SkillSurf/cmos-pll-ihp-sg13g2/Team Designs/Team 2 Design/design_data/xschem/plots/vctl_vs_freq.xlsx

vctl | fnew | f old
0.4 | 0.0228 | 0.00296
0.5 | 0.132 | 0.021
0.6 | 0.39 | 0.025
0.7 | 0.708 | 0.076
0.8 | 1.077 | 0.207
0.9 | 1.316 | 0.465
1 | 1.42 | 0.86
1.1 | 1.5 | 1.44
1.2 | 1.46 | 2.1
