SkillSurf/cmos-pll-ihp-sg13g2/Combined_Design/design_data/gds/images/11Stage_vco_new_gds.png

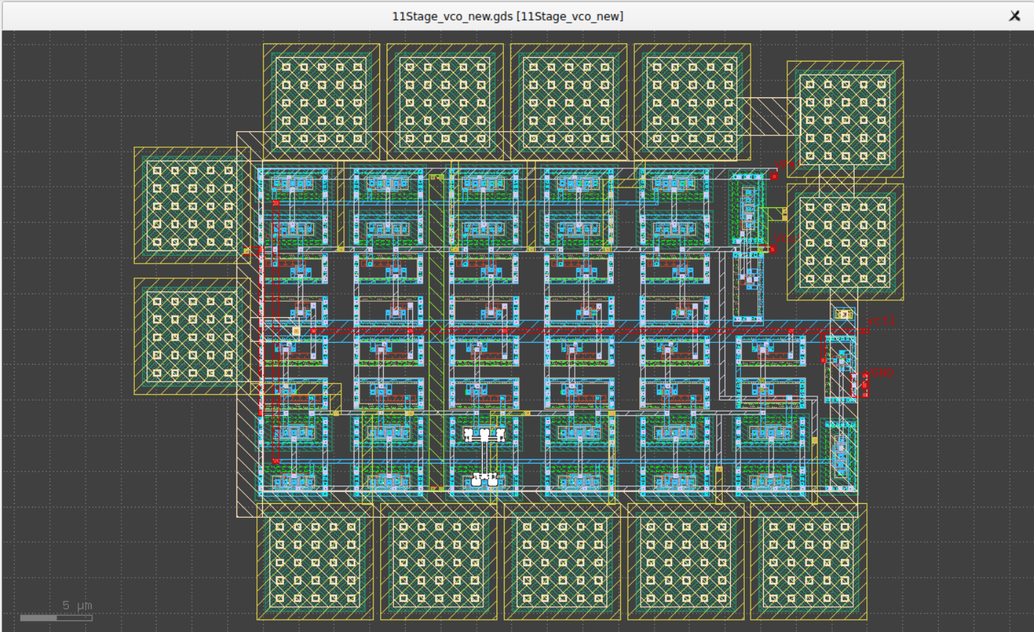
Combined_Design/design_data/gds/images/11Stage_vco_new_gds.png
