SkillSurf/cmos-pll-ihp-sg13g2/Combined_Design/design_data/gds/images/bias_gen_layout.png

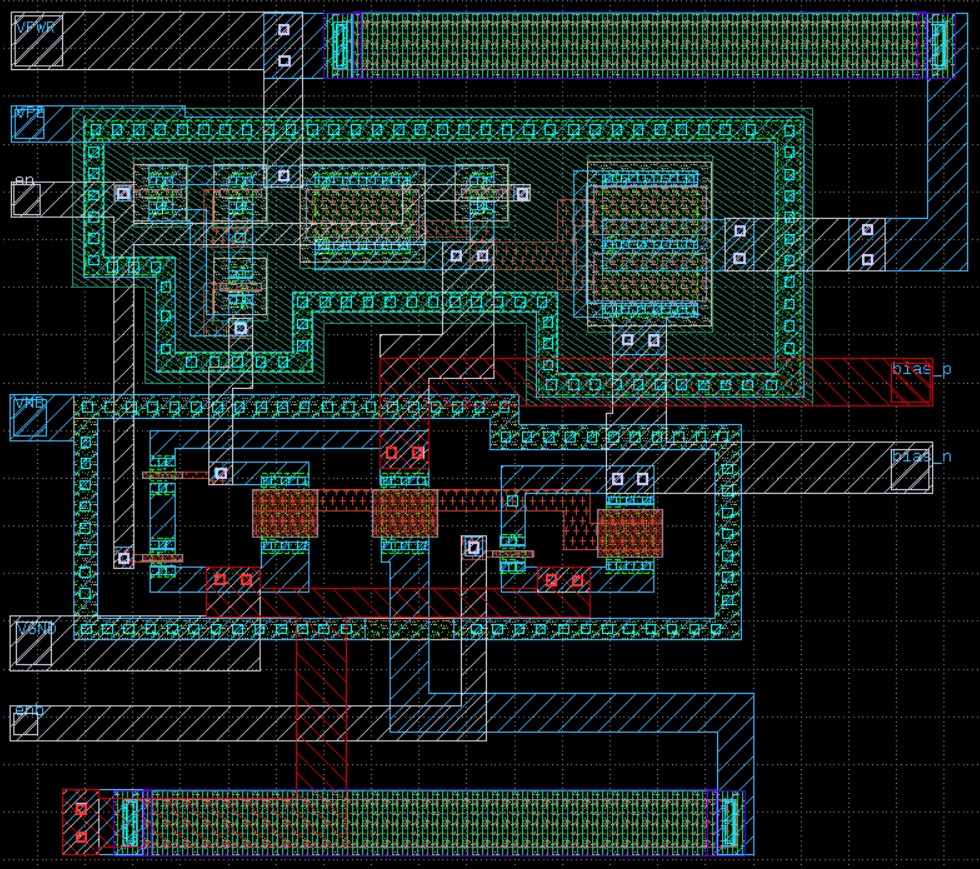
Combined_Design/design_data/gds/images/bias_gen_layout.png
