SkillSurf/cmos-pll-ihp-sg13g2/Combined_Design/design_data/gds/images/charge_pump.png

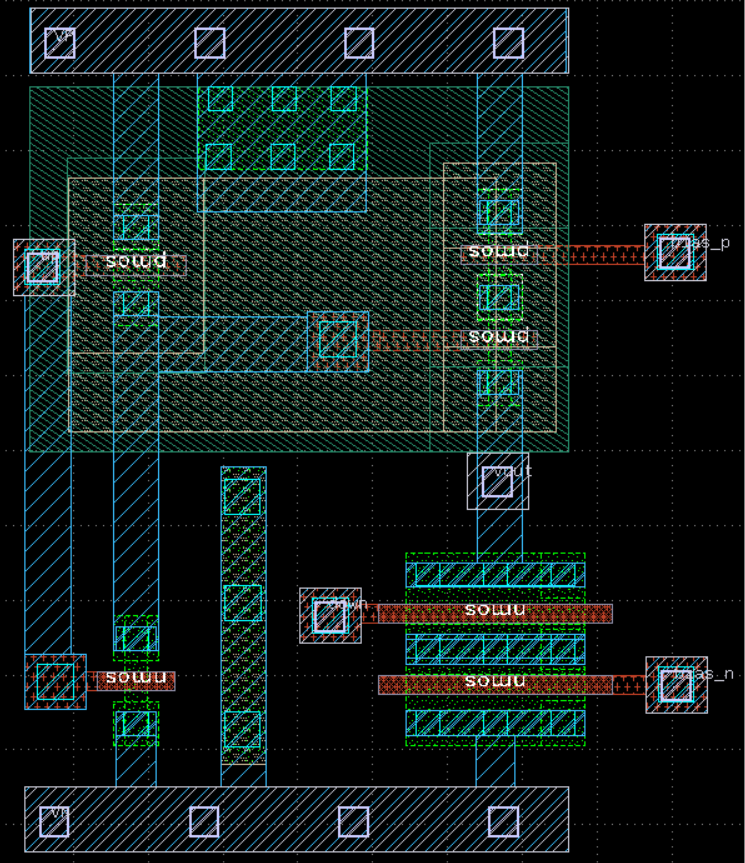
Combined_Design/design_data/gds/images/charge_pump.png
