SkillSurf/cmos-pll-ihp-sg13g2/Combined_Design/design_data/gds/images/loop_filter.png

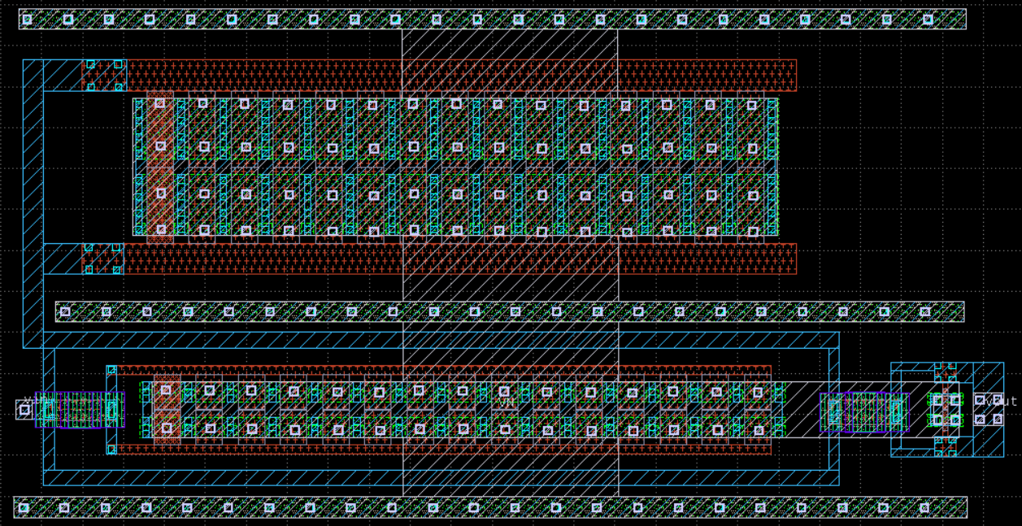
Combined_Design/design_data/gds/images/loop_filter.png
