SkillSurf/cmos-pll-ihp-sg13g2/Combined_Design/design_data/gds/images/pll_3bitDiv_filled.png

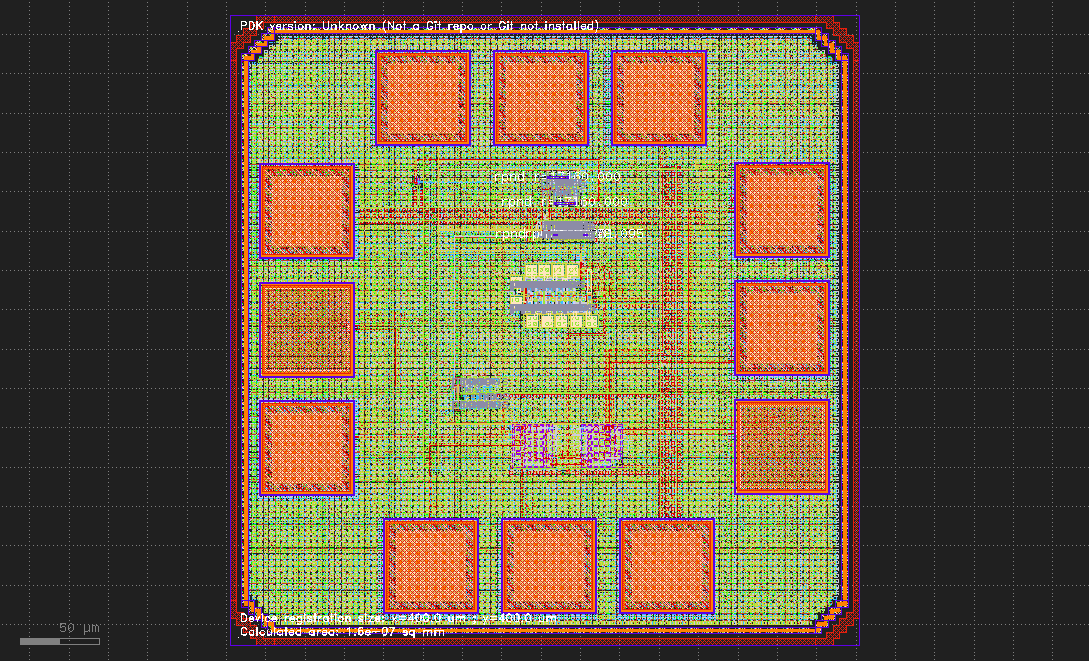
Combined_Design/design_data/gds/images/pll_3bitDiv_filled.png
