SkillSurf/cmos-pll-ihp-sg13g2/Combined_Design/design_data/gds/images/pll_layout_with_fillers.png

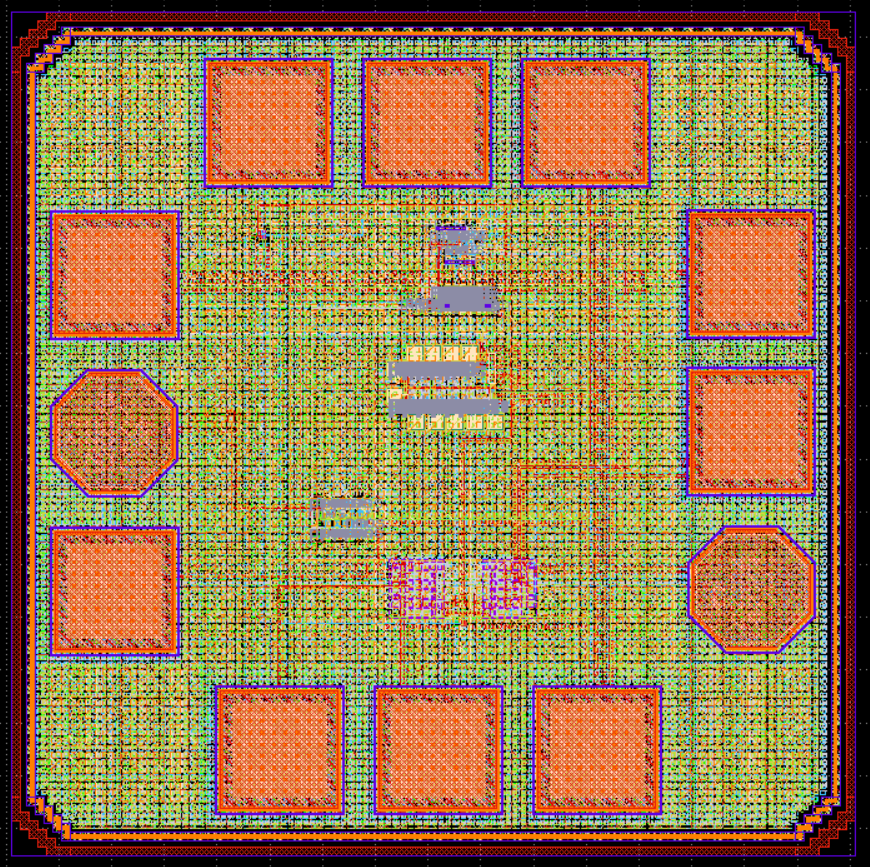
Combined_Design/design_data/gds/images/pll_layout_with_fillers.png
