SkillSurf/cmos-pll-ihp-sg13g2/Combined_Design/design_data/gds/images/PLL_pinout.png

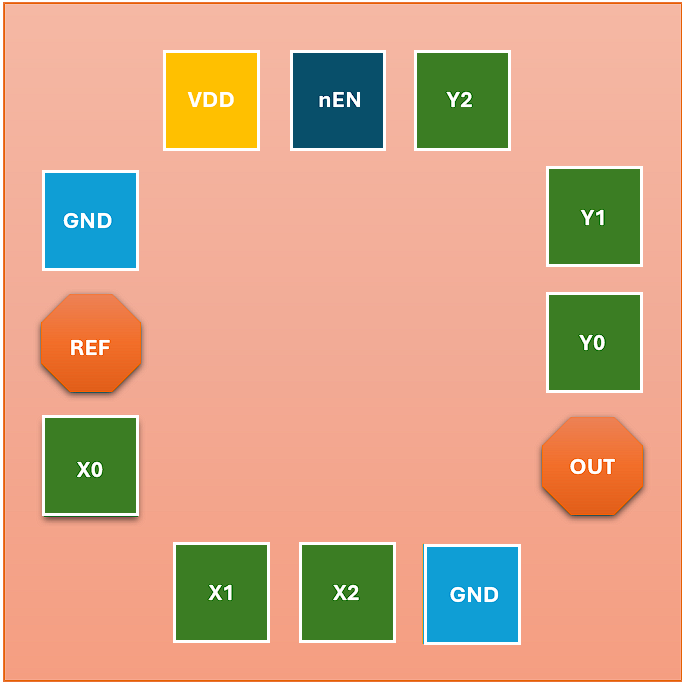
Combined_Design/design_data/gds/images/PLL_pinout.png
