SkillSurf/cmos-pll-ihp-sg13g2/Combined_Design/design_data/lvs/pll_3bitDiv.png

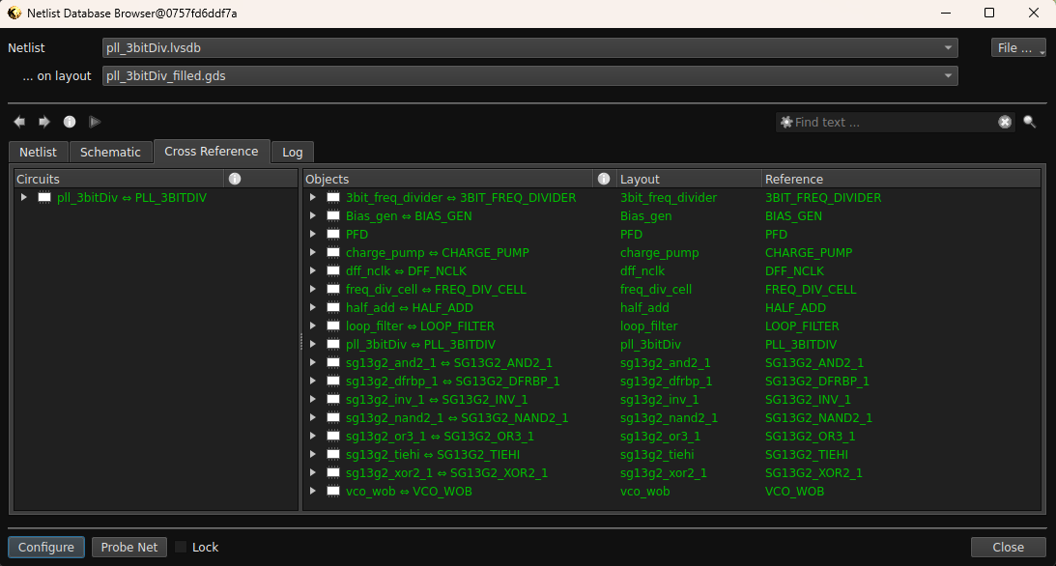
Combined_Design/design_data/lvs/pll_3bitDiv.png
