SkillSurf/cmos-pll-ihp-sg13g2/Combined_Design/design_data/xschem/images/2bit_freq_divider.png

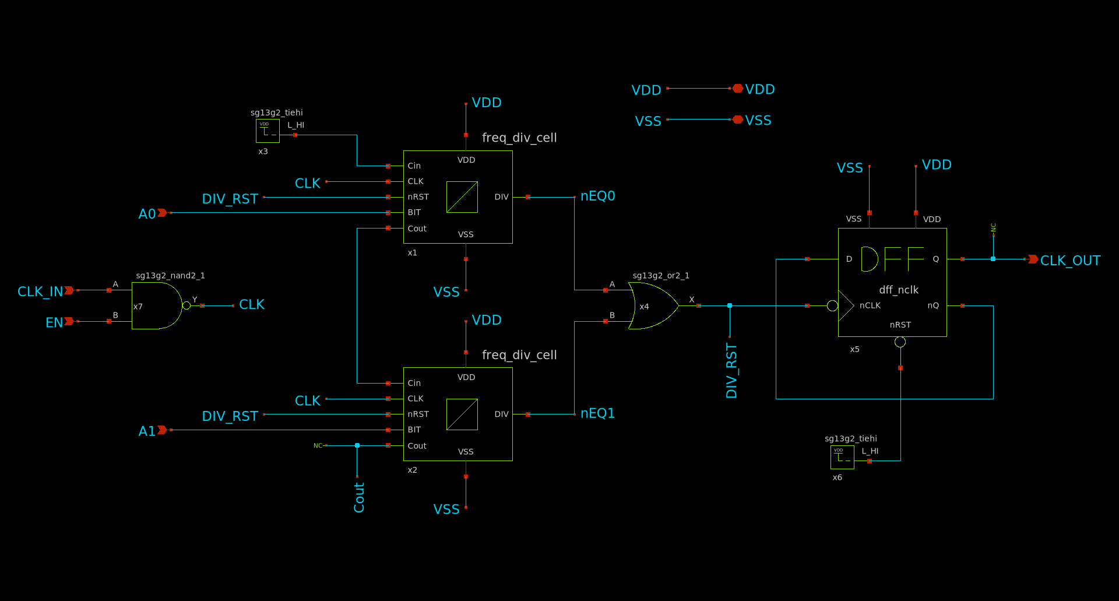
Combined_Design/design_data/xschem/images/2bit_freq_divider.png
