SkillSurf/cmos-pll-ihp-sg13g2/Combined_Design/design_data/xschem/images/3bit_freq_divider_pex_tb.png

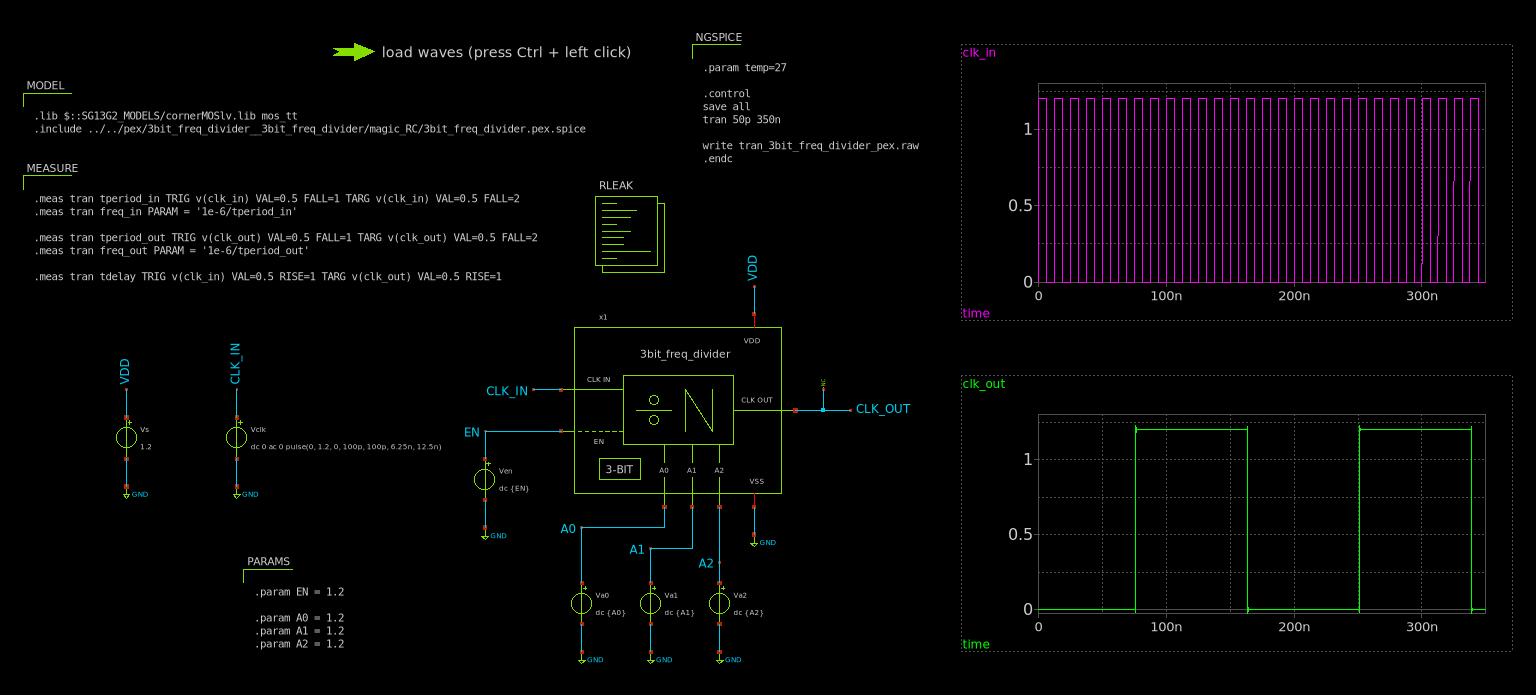
Combined_Design/design_data/xschem/images/3bit_freq_divider_pex_tb.png
