SkillSurf/cmos-pll-ihp-sg13g2/Combined_Design/design_data/xschem/images/11Stages_VCO_sch.png

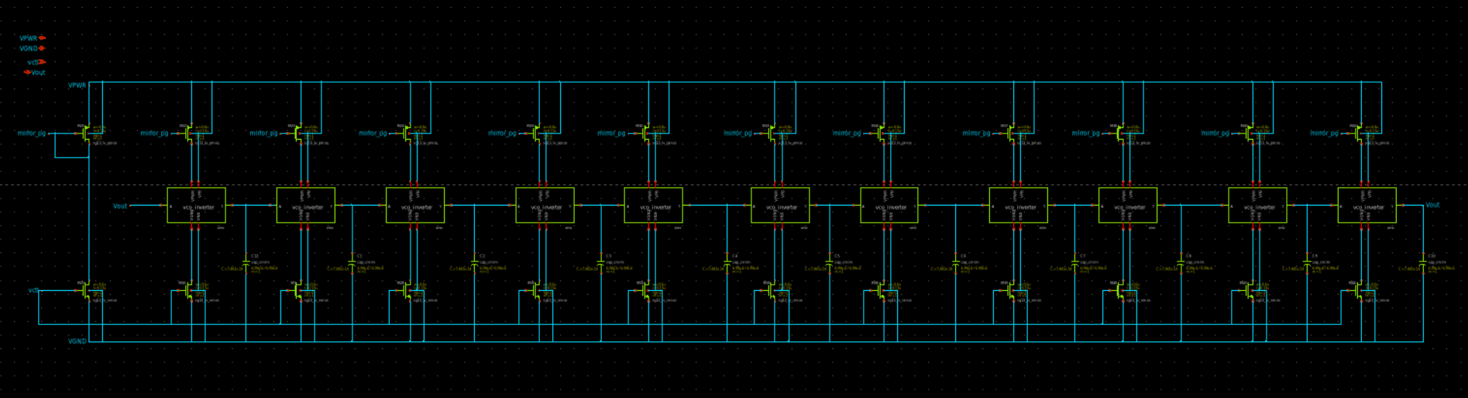
Combined_Design/design_data/xschem/images/11Stages_VCO_sch.png
