SkillSurf/cmos-pll-ihp-sg13g2/Combined_Design/design_data/xschem/images/11Stages_VCO_tb.png

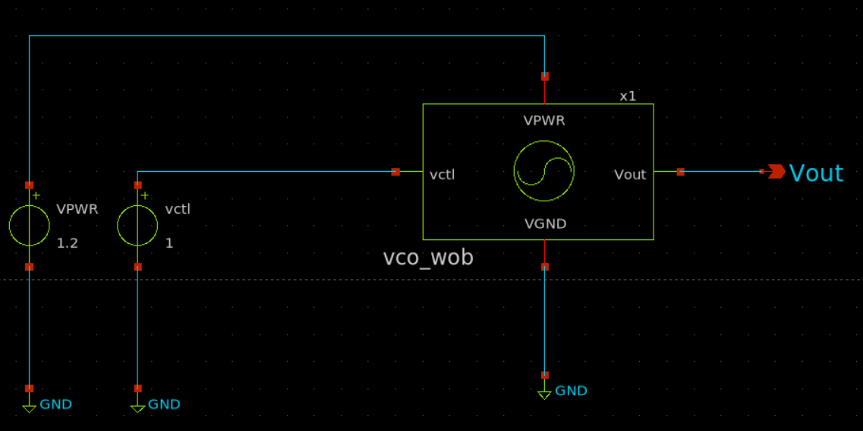
Combined_Design/design_data/xschem/images/11Stages_VCO_tb.png
