SkillSurf/cmos-pll-ihp-sg13g2/Combined_Design/design_data/xschem/images/bias_gen_sch.png

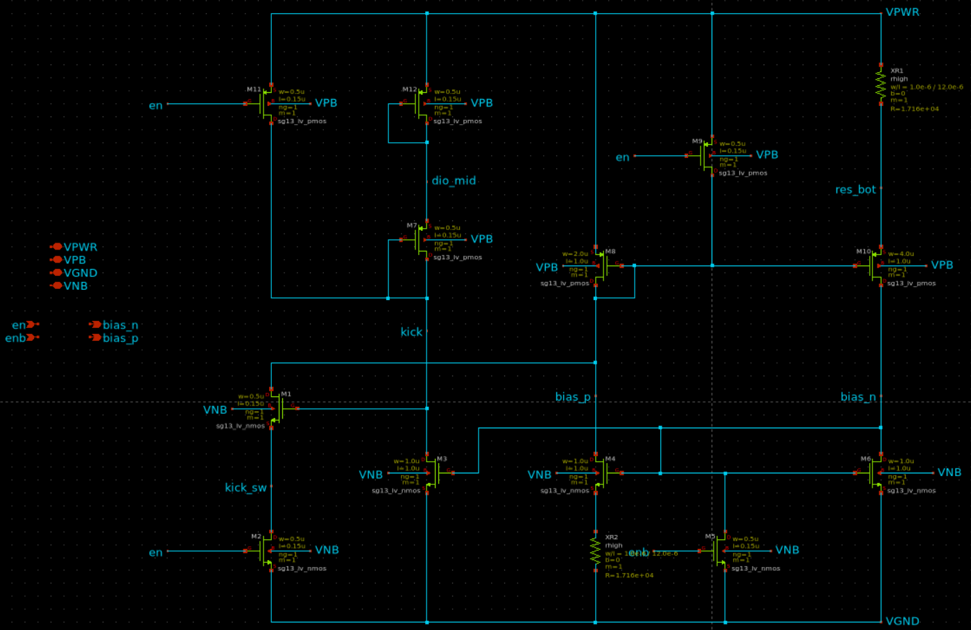
Combined_Design/design_data/xschem/images/bias_gen_sch.png
