SkillSurf/cmos-pll-ihp-sg13g2/Combined_Design/design_data/xschem/images/charge_pump_lpf_bias_gen_tb.png

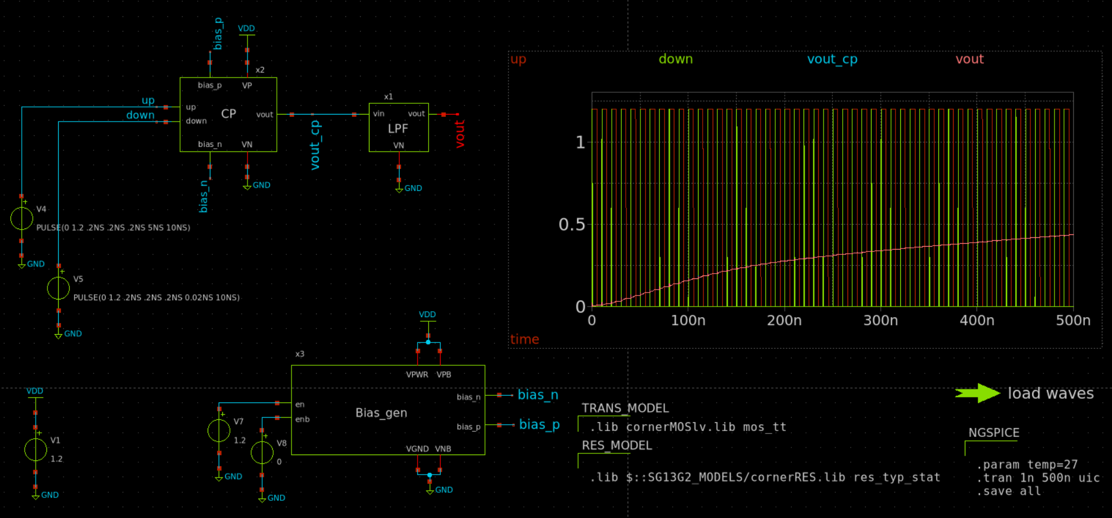
Combined_Design/design_data/xschem/images/charge_pump_lpf_bias_gen_tb.png
