SkillSurf/cmos-pll-ihp-sg13g2/Combined_Design/design_data/xschem/images/charge_pump_sch.png

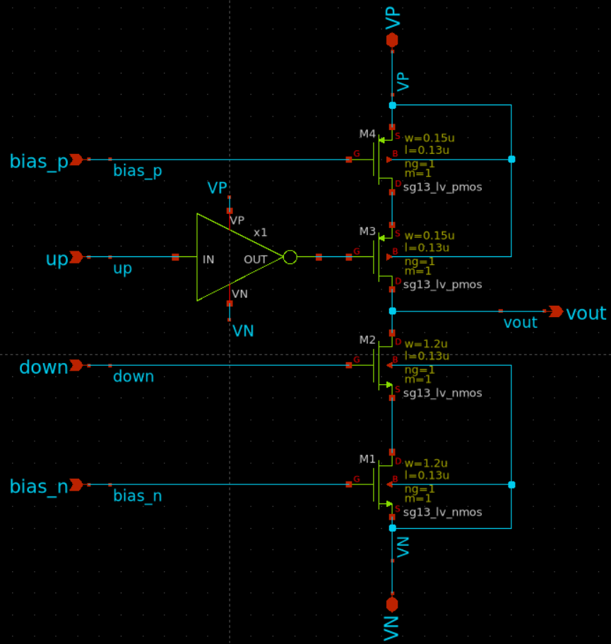
Combined_Design/design_data/xschem/images/charge_pump_sch.png
