SkillSurf/cmos-pll-ihp-sg13g2/Combined_Design/design_data/xschem/images/dff_nclk_tb.png

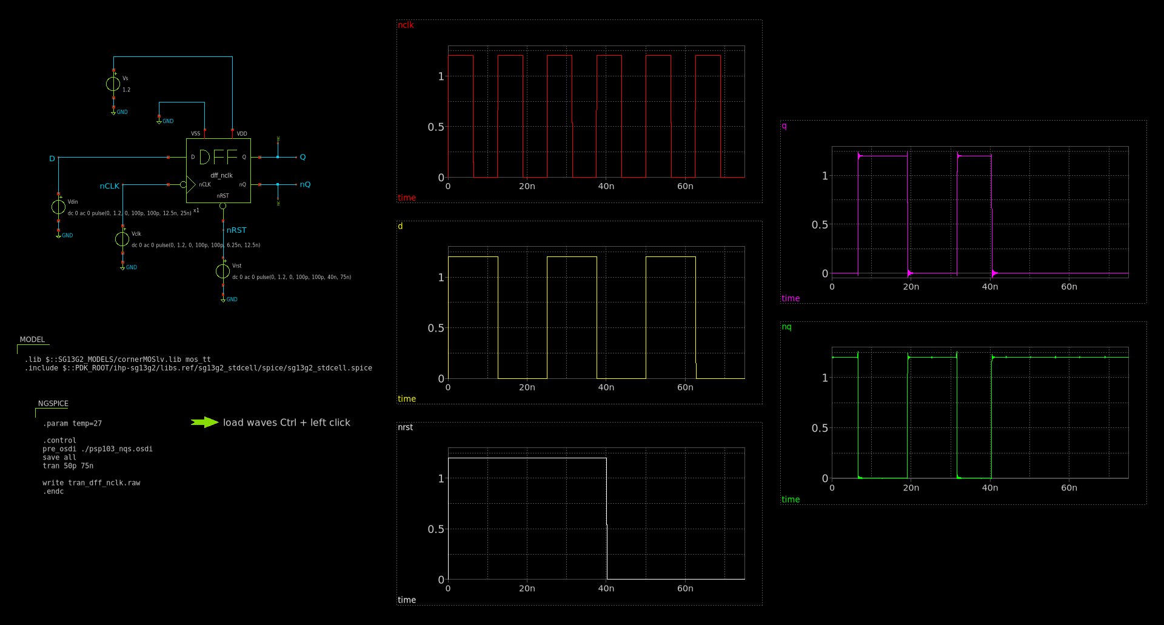
Combined_Design/design_data/xschem/images/dff_nclk_tb.png
