SkillSurf/cmos-pll-ihp-sg13g2/Combined_Design/design_data/xschem/images/FFT_Vcon=0.5.png

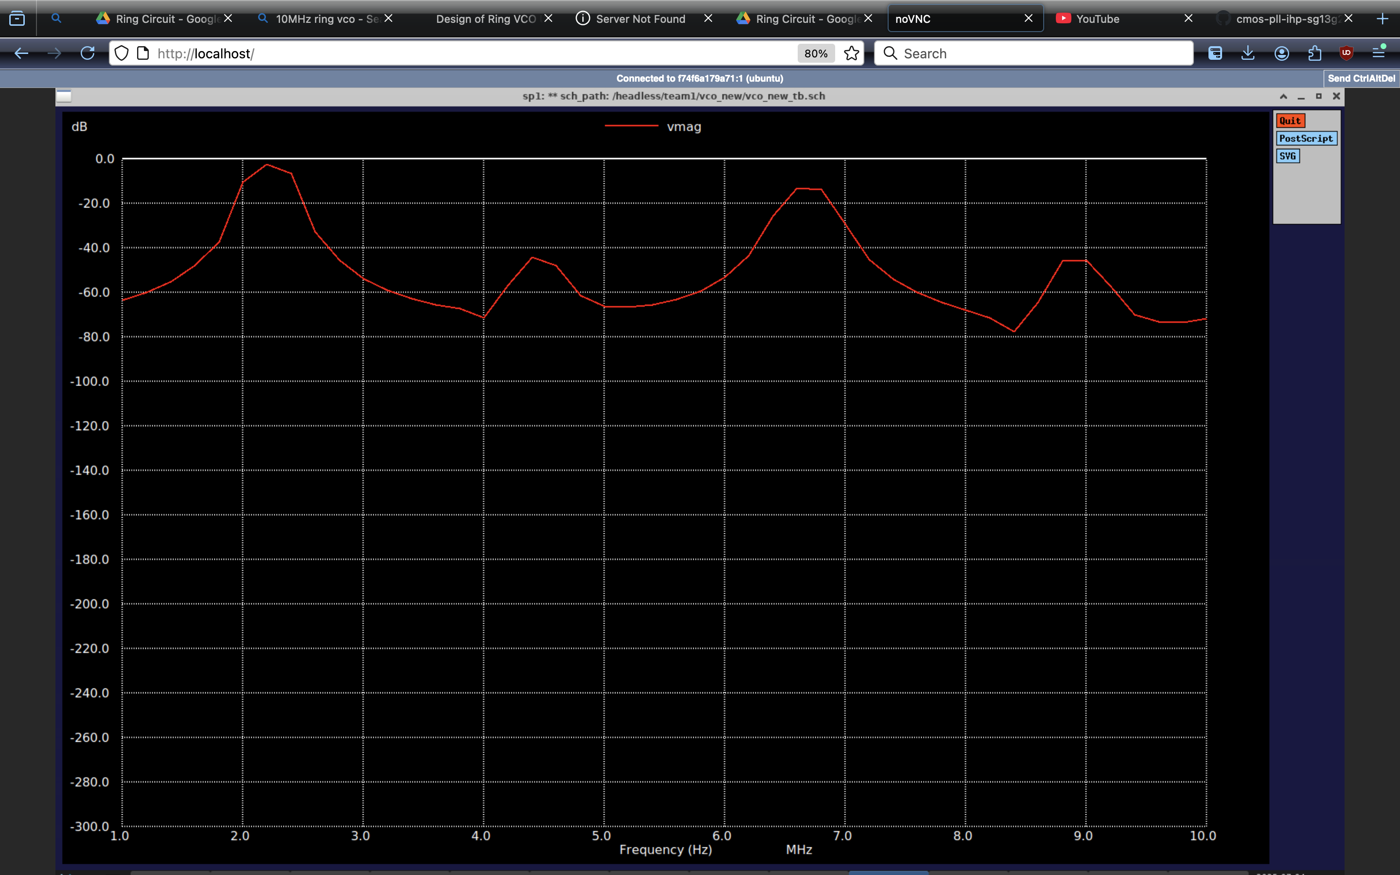
Combined_Design/design_data/xschem/images/FFT_Vcon=0.5.png
