SkillSurf/cmos-pll-ihp-sg13g2/Combined_Design/design_data/xschem/images/FFT_Vcon=1.png

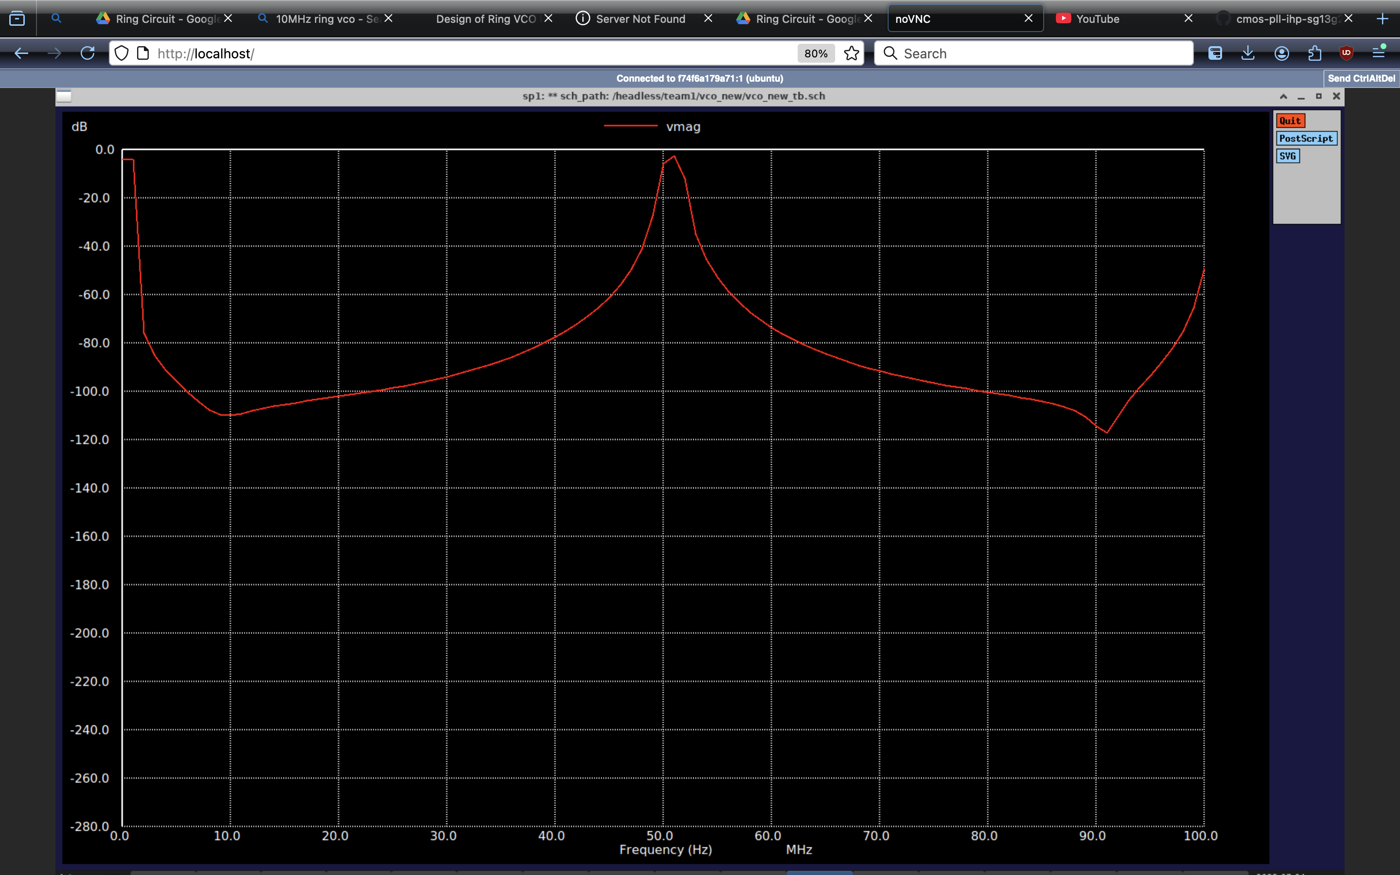
Combined_Design/design_data/xschem/images/FFT_Vcon=1.png
