SkillSurf/cmos-pll-ihp-sg13g2/Combined_Design/design_data/xschem/images/freq_div_cell.png

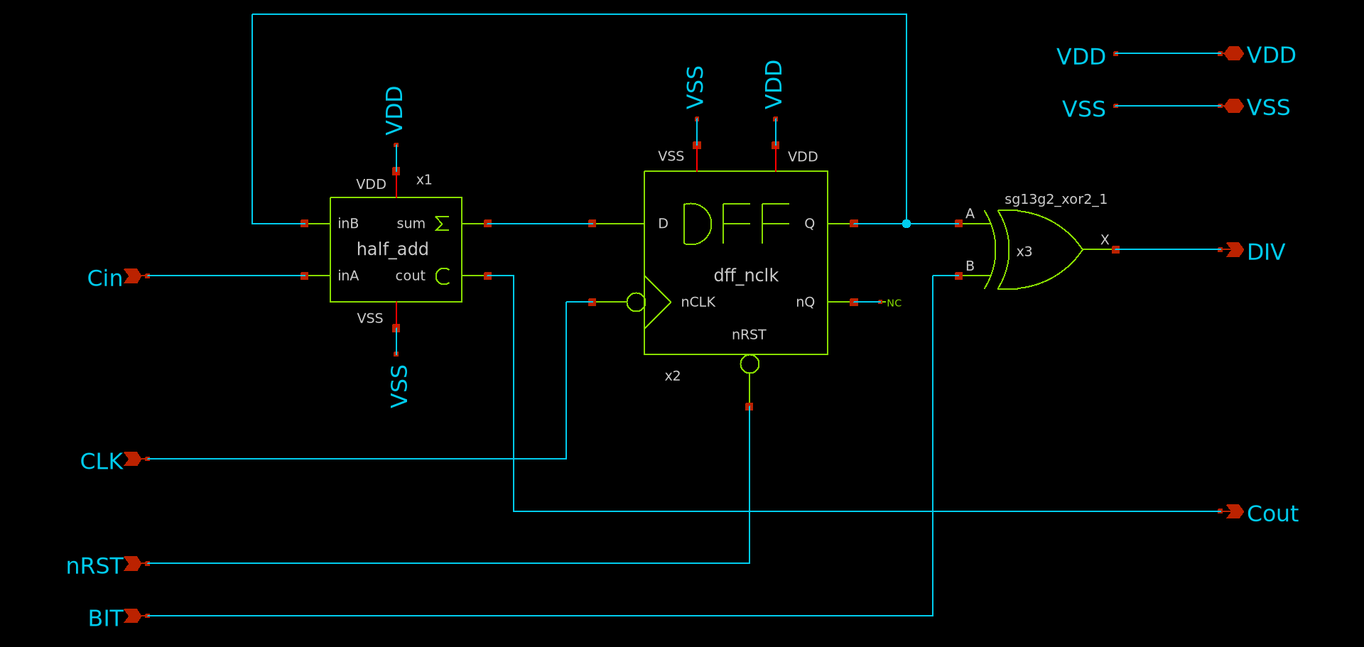
Combined_Design/design_data/xschem/images/freq_div_cell.png
