SkillSurf/cmos-pll-ihp-sg13g2/Combined_Design/design_data/xschem/images/freq_div_cell_tb.png

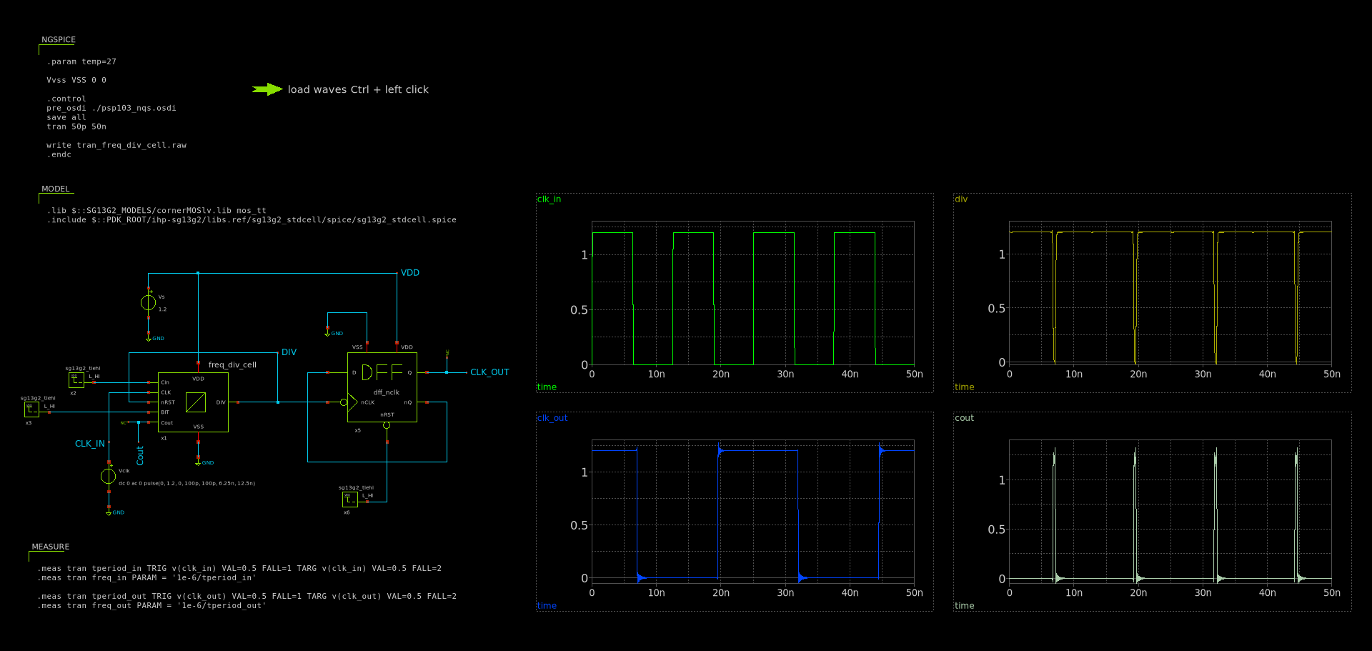
Combined_Design/design_data/xschem/images/freq_div_cell_tb.png
