SkillSurf/cmos-pll-ihp-sg13g2/Combined_Design/design_data/xschem/images/half_add_tb.png

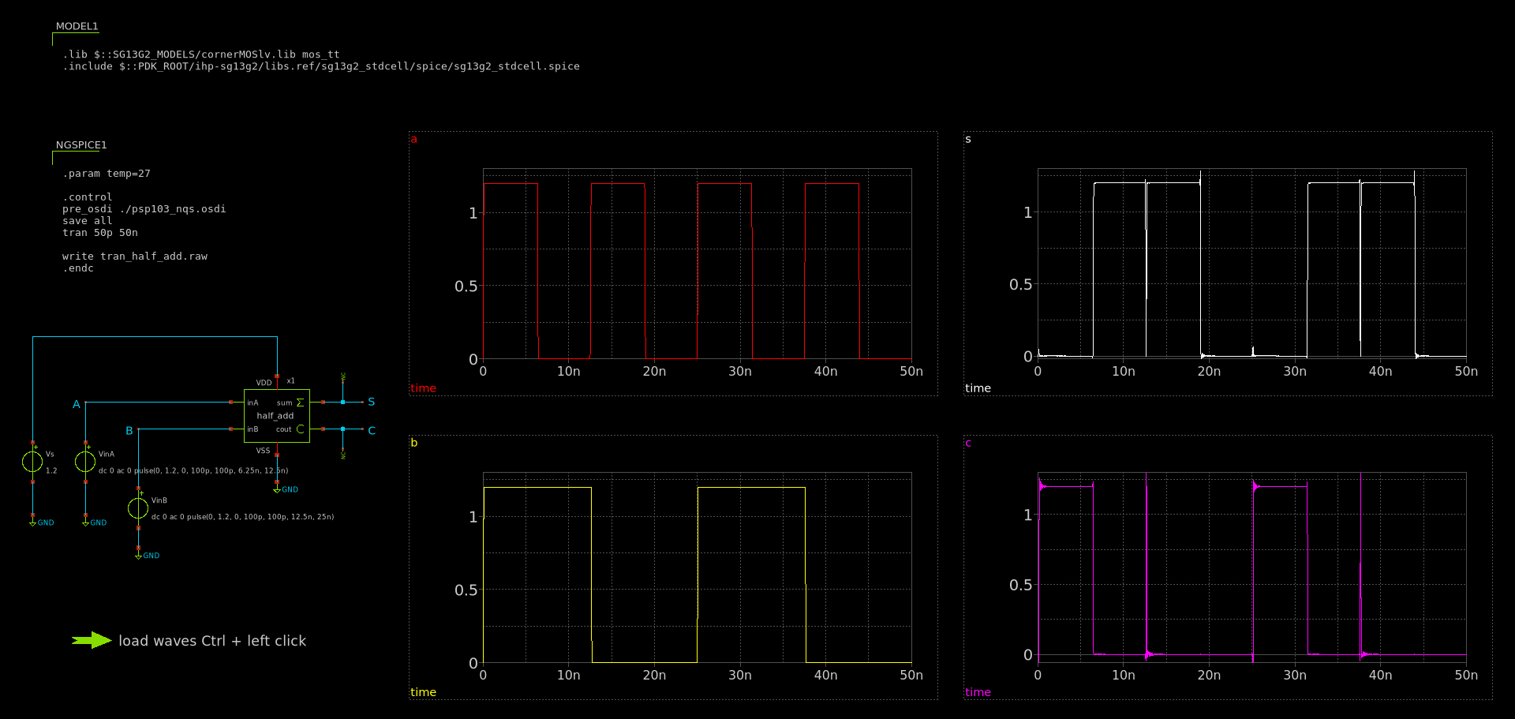
Combined_Design/design_data/xschem/images/half_add_tb.png
