SkillSurf/cmos-pll-ihp-sg13g2/Combined_Design/design_data/xschem/images/PFD.png

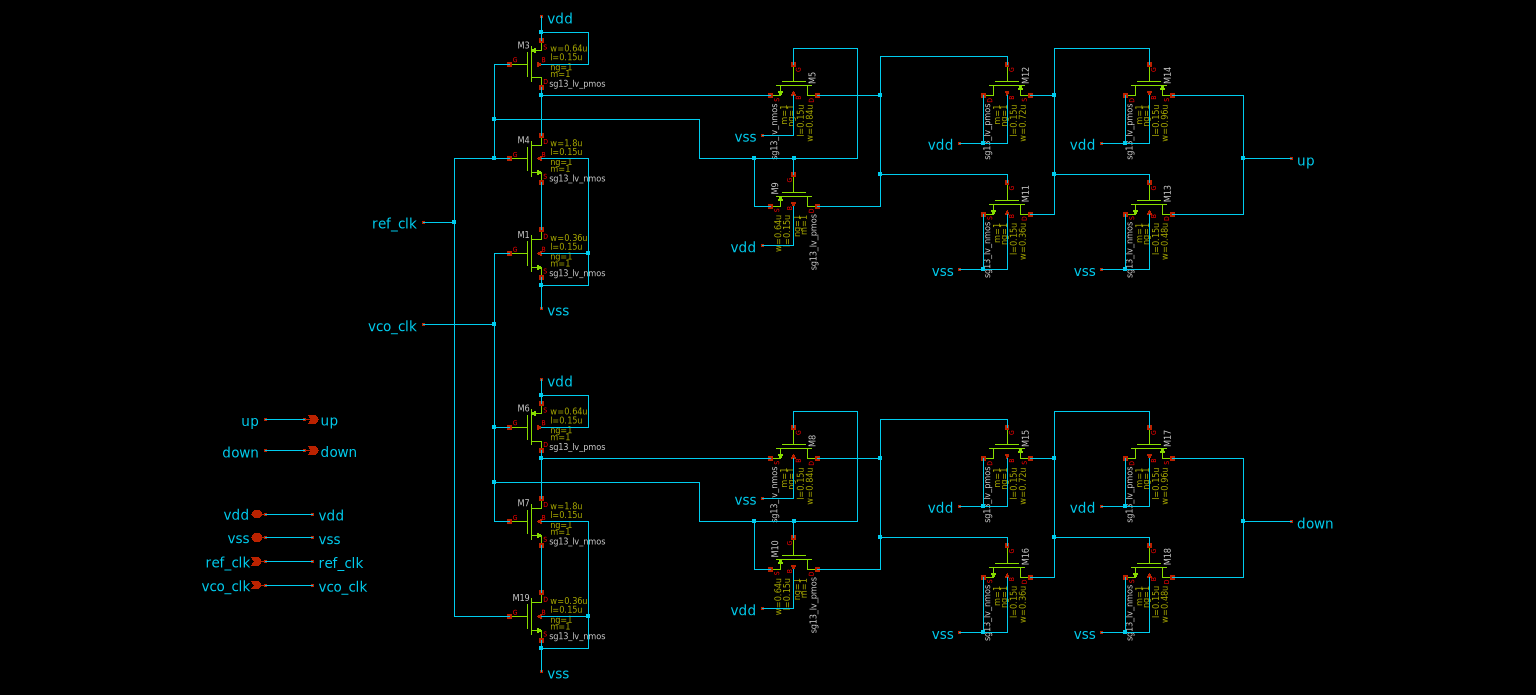
Combined_Design/design_data/xschem/images/PFD.png
