SkillSurf/cmos-pll-ihp-sg13g2/Combined_Design/design_data/xschem/images/pll_3bitDiv.png

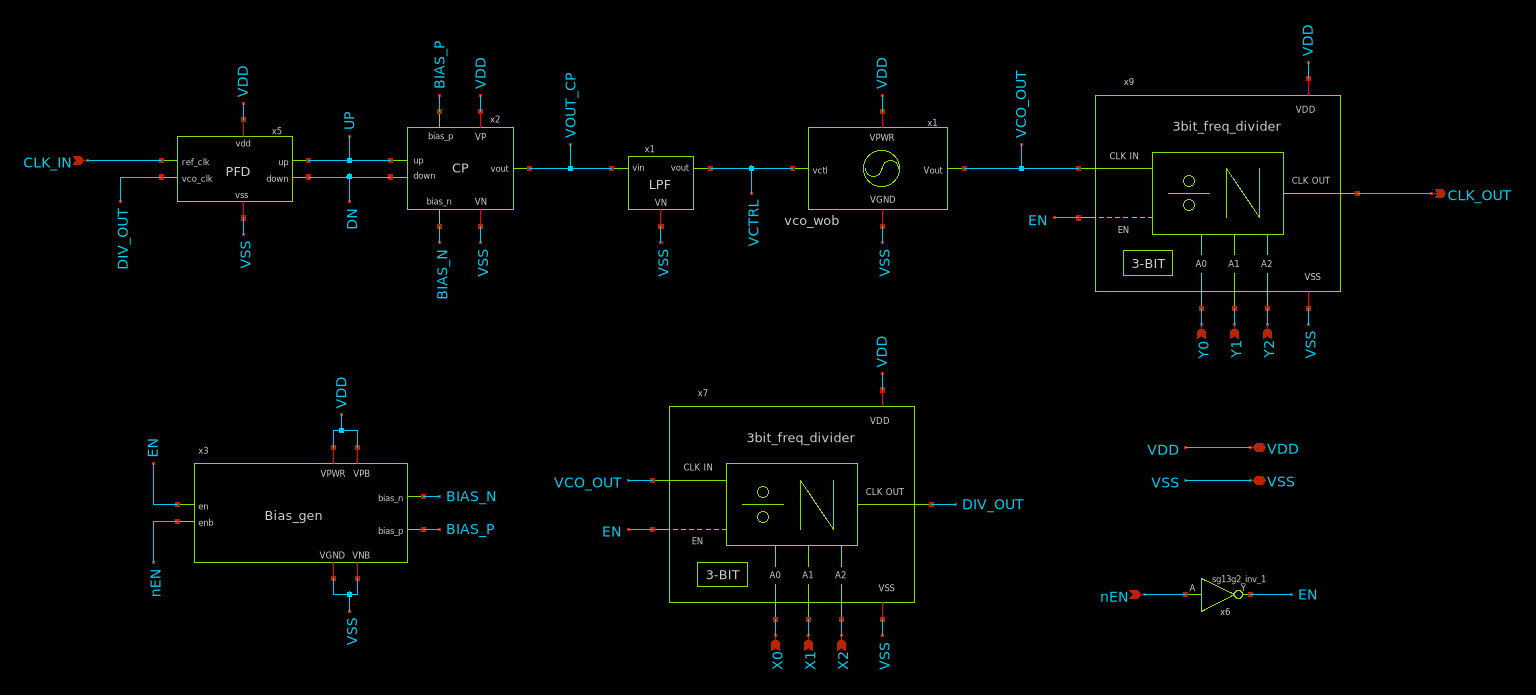
Combined_Design/design_data/xschem/images/pll_3bitDiv.png
