SkillSurf/cmos-pll-ihp-sg13g2/Combined_Design/design_data/xschem/images/pll_3bitDiv_pex_tb_2f.png

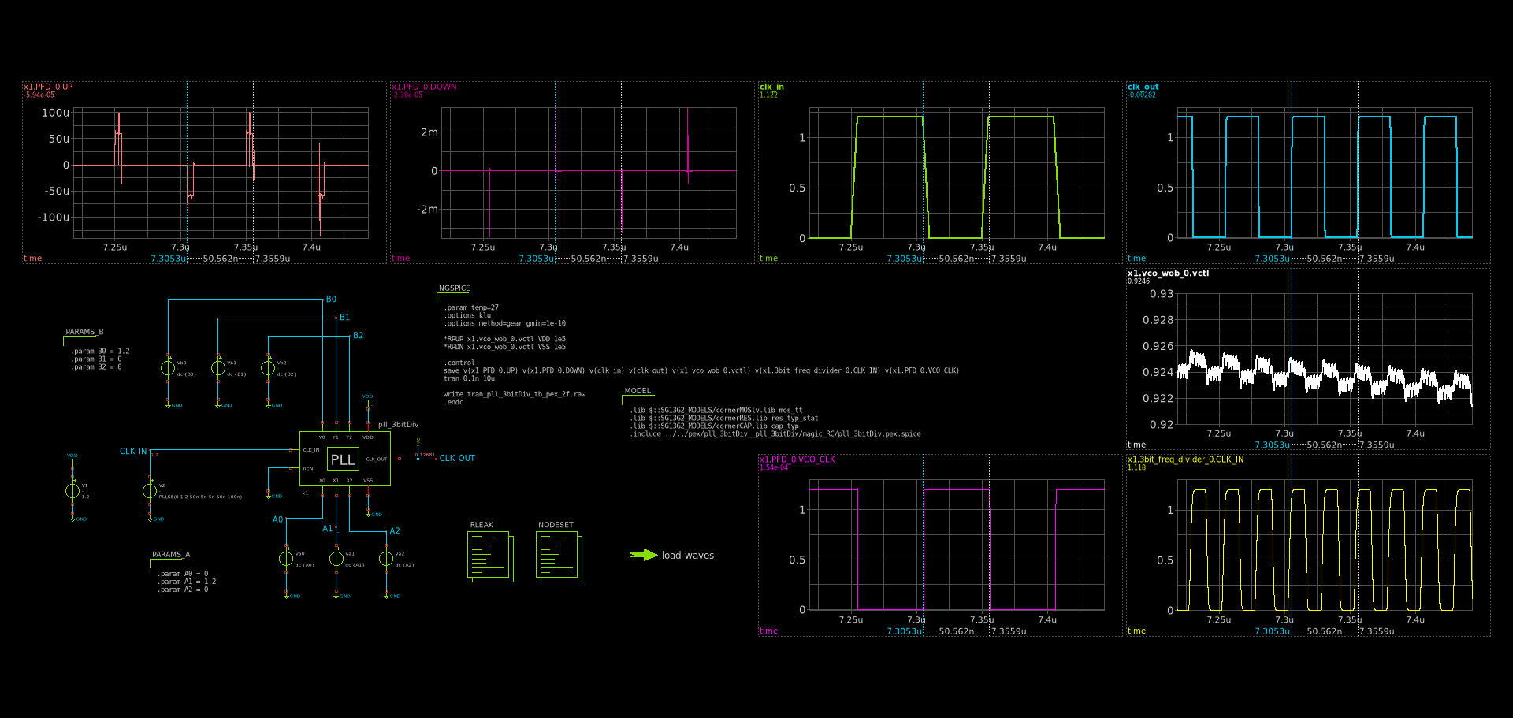
Combined_Design/design_data/xschem/images/pll_3bitDiv_pex_tb_2f.png
