SkillSurf/cmos-pll-ihp-sg13g2/Combined_Design/design_data/xschem/images/Transient_Vcon=0.8.png

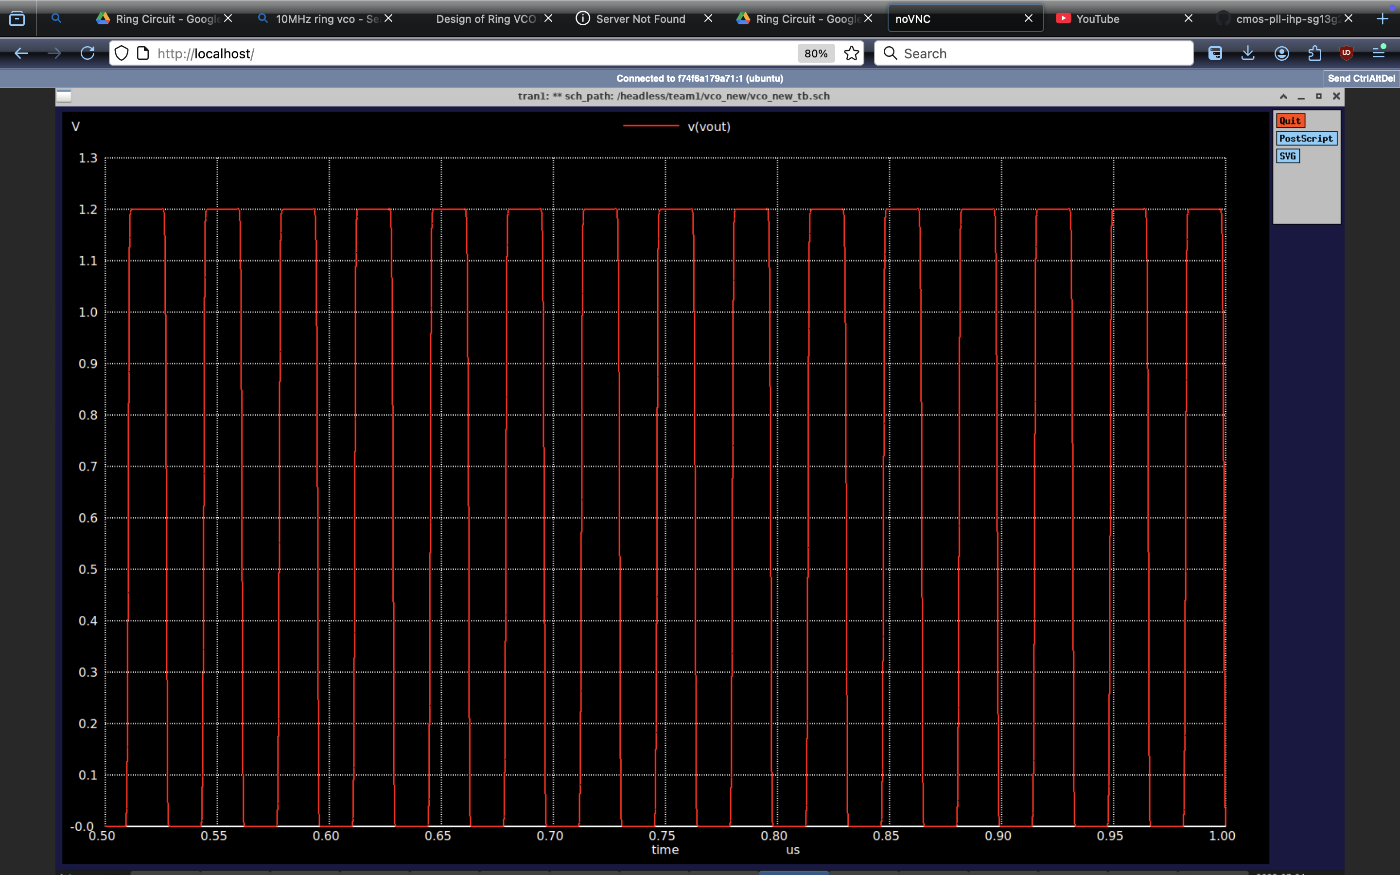
Combined_Design/design_data/xschem/images/Transient_Vcon=0.8.png
