SkillSurf/cmos-pll-ihp-sg13g2/Combined_Design/design_data/xschem/images/Transient_Vcon=1.2.png

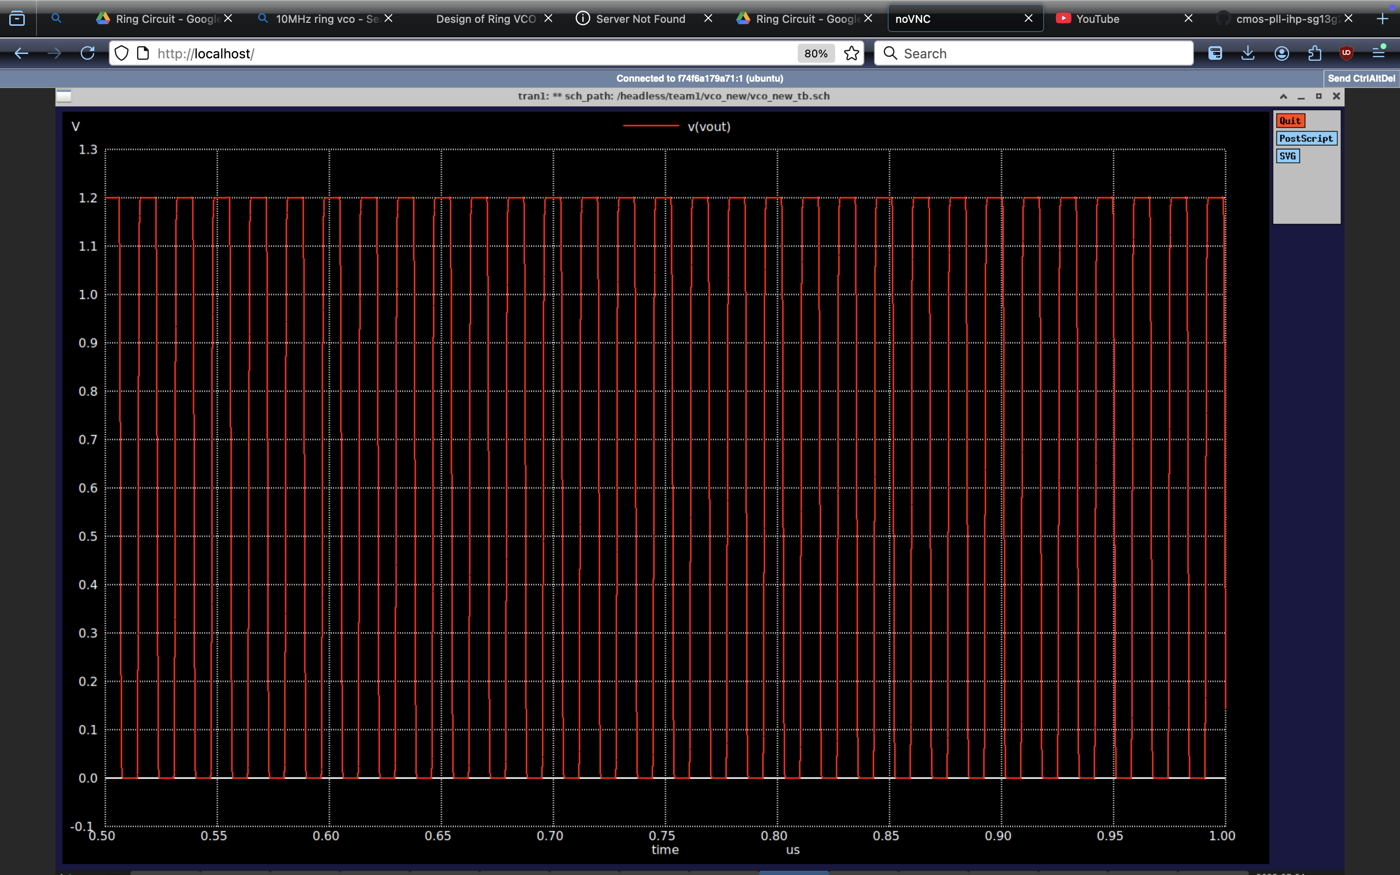
Combined_Design/design_data/xschem/images/Transient_Vcon=1.2.png
