SkillSurf/cmos-pll-ihp-sg13g2/Combined_Design/design_data/xschem/images/VCO_Frequency_spectrum.jpeg

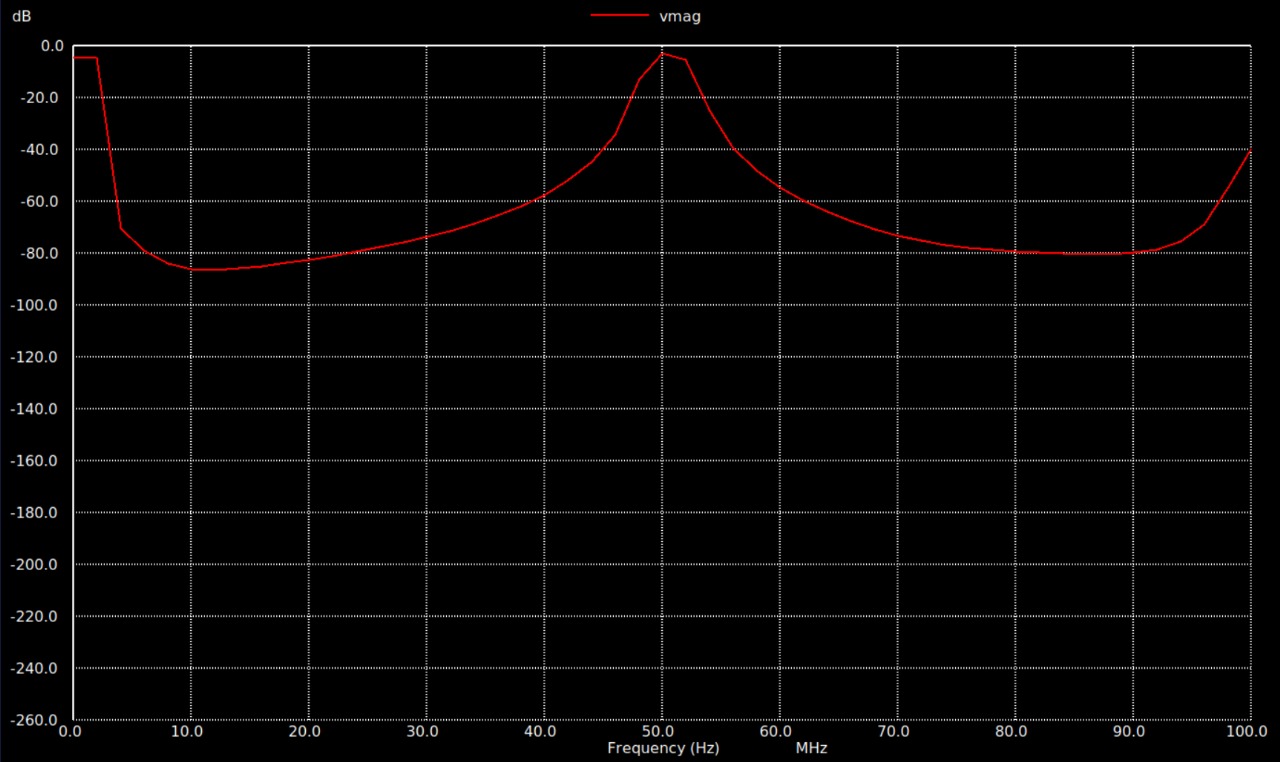
Combined_Design/design_data/xschem/images/VCO_Frequency_spectrum.jpeg
