SkillSurf/cmos-pll-ihp-sg13g2/Combined_Design/design_data/xschem/images/VCO_Out.jpeg

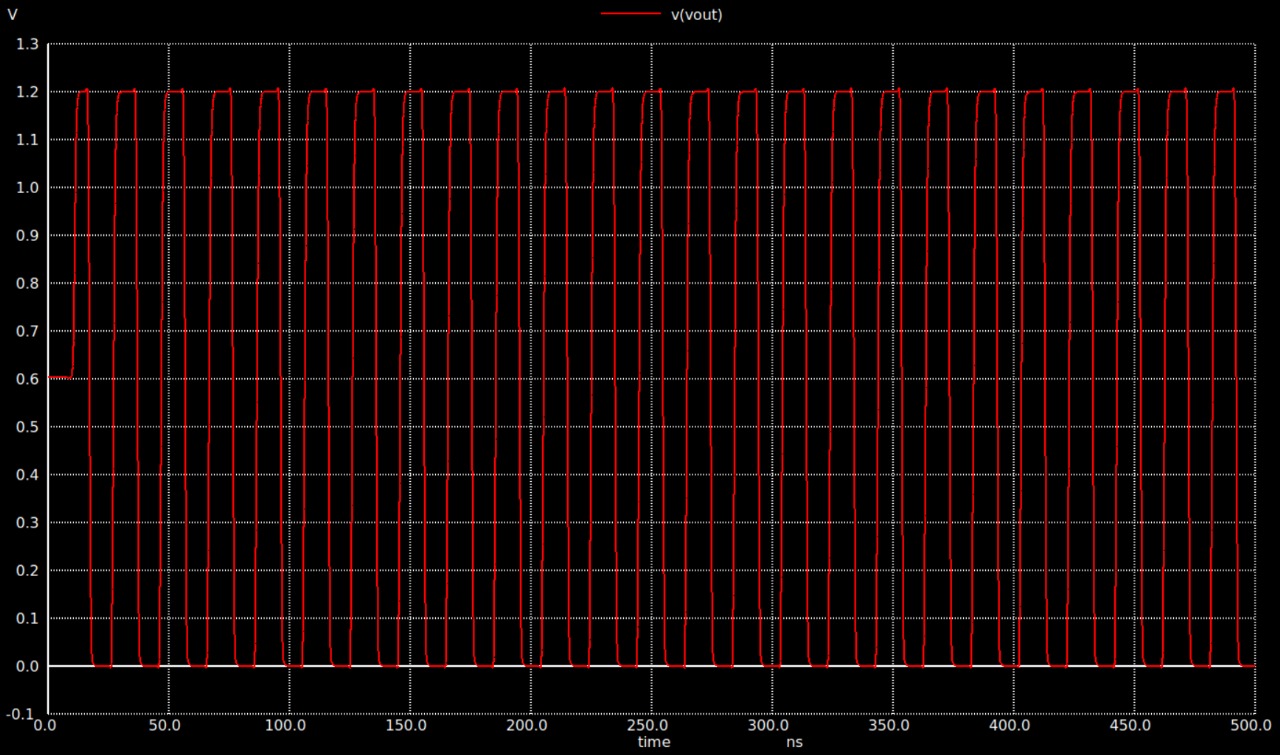
Combined_Design/design_data/xschem/images/VCO_Out.jpeg
