SkillSurf/cmos-pll-ihp-sg13g2/Combined_Design/design_data/xschem/images/vctl_up.png

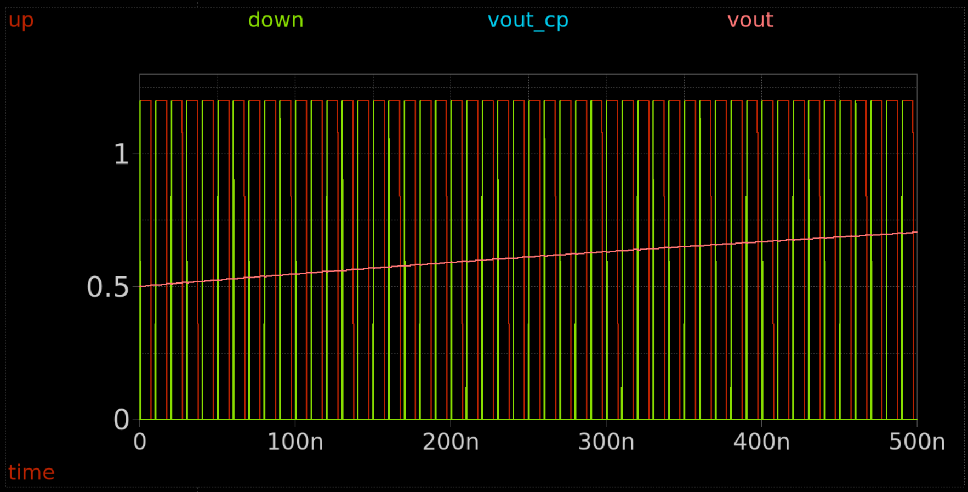
Combined_Design/design_data/xschem/images/vctl_up.png
