SkillSurf/cmos-pll-ihp-sg13g2/Team Designs/Team 1 Design/design_data/gds/images/New_2NAND_Team1_Layout.png

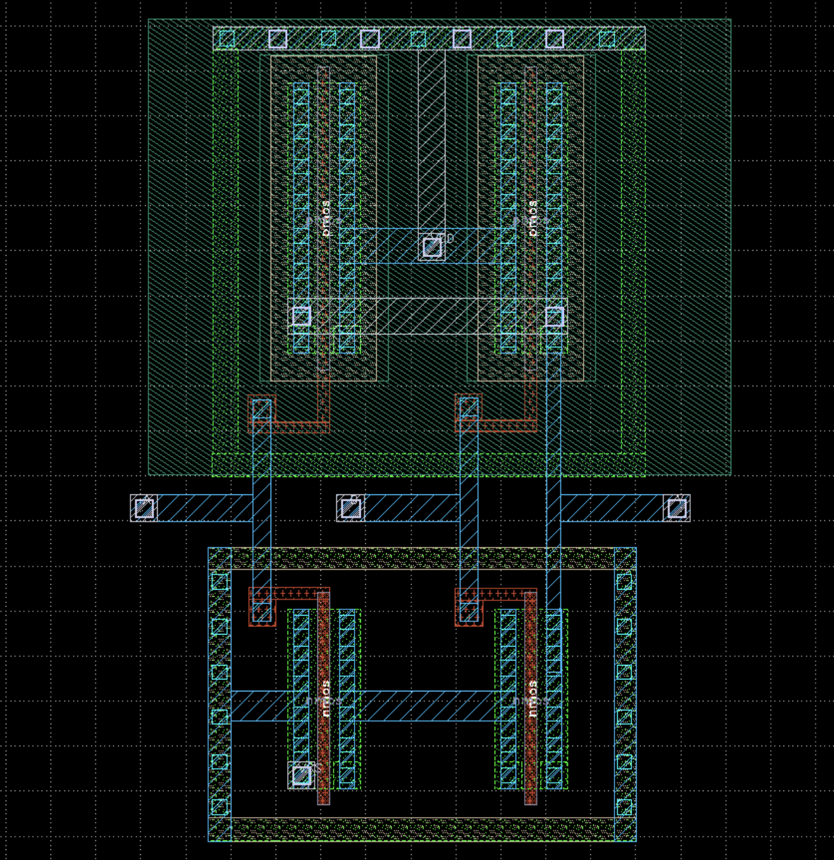
Team Designs/Team 1 Design/design_data/gds/images/New_2NAND_Team1_Layout.png
