SkillSurf/cmos-pll-ihp-sg13g2/Team Designs/Team 1 Design/design_data/gds/images/Team1_FD.png

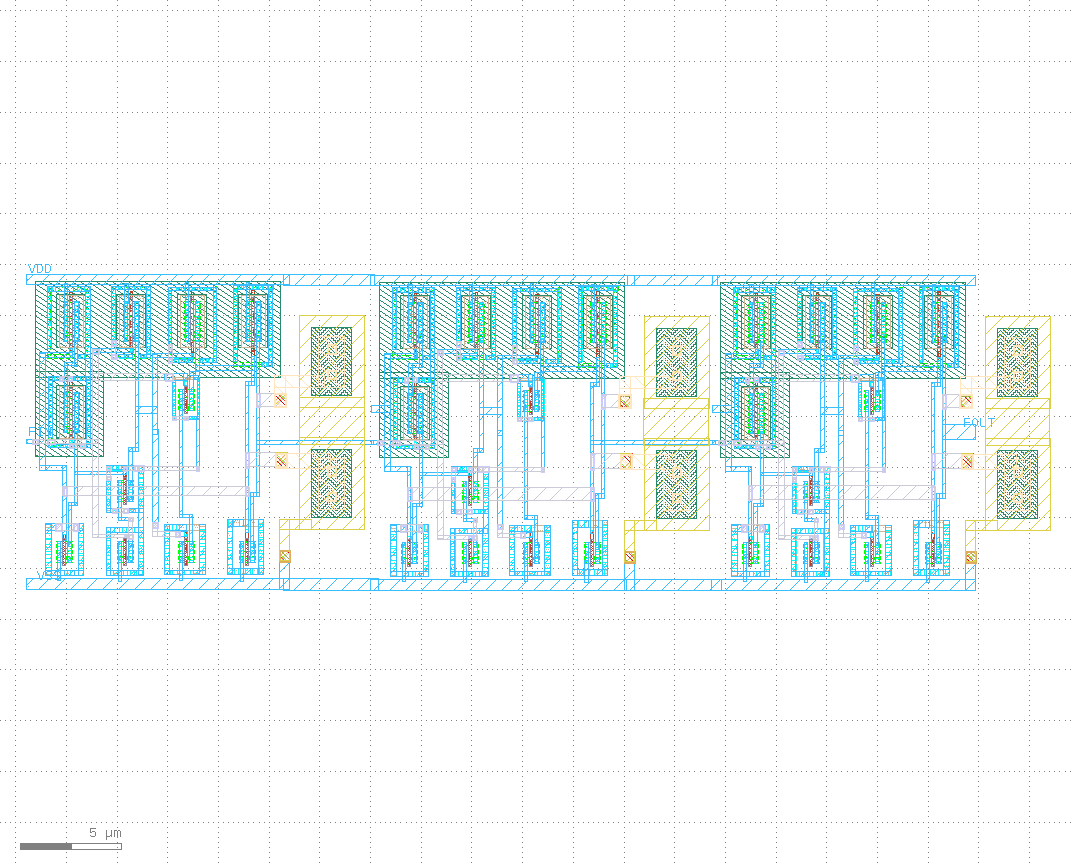
Team Designs/Team 1 Design/design_data/gds/images/Team1_FD.png
