SkillSurf/cmos-pll-ihp-sg13g2/Team Designs/Team 1 Design/design_data/xschem/2_Input_NAND/images/2NAND.sch.png

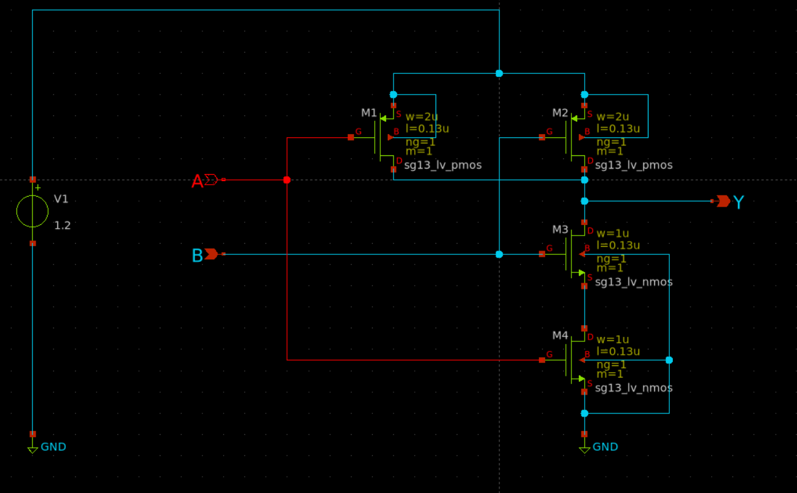
Team Designs/Team 1 Design/design_data/xschem/2_Input_NAND/images/2NAND.sch.png
