SkillSurf/cmos-pll-ihp-sg13g2/Team Designs/Team 1 Design/design_data/xschem/3_Input_NAND/images/3NAND.sym.png

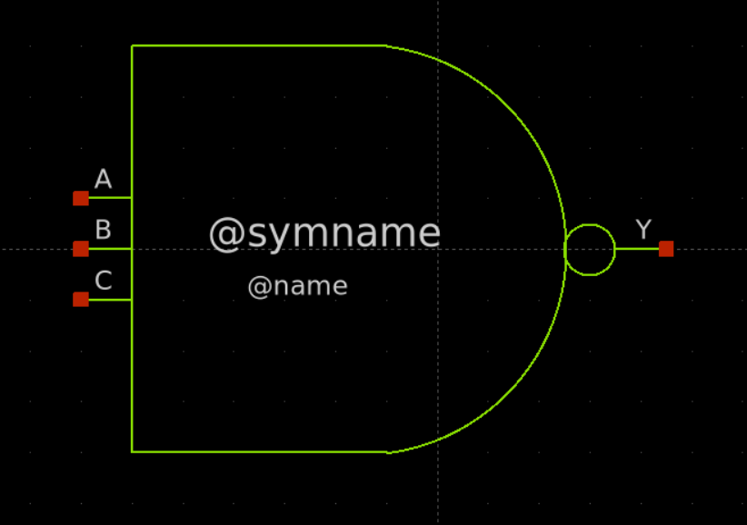
Team Designs/Team 1 Design/design_data/xschem/3_Input_NAND/images/3NAND.sym.png
