SkillSurf/cmos-pll-ihp-sg13g2/Team Designs/Team 1 Design/design_data/xschem/CP_LF/images/CP_LF.sym.png

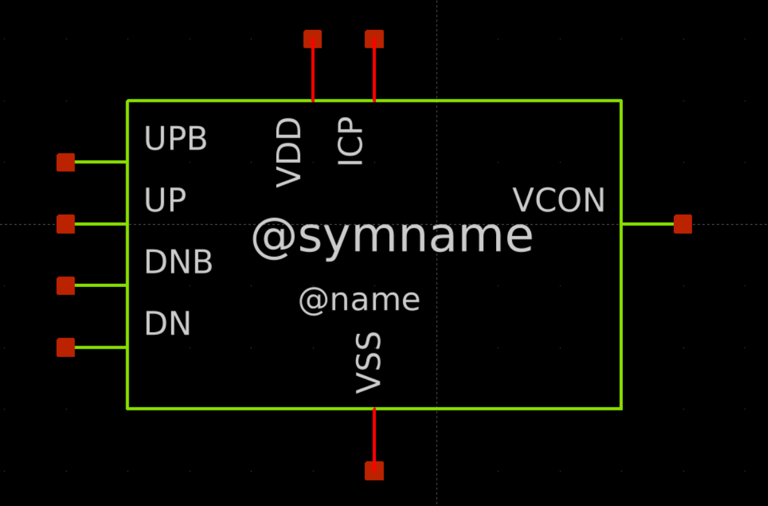
Team Designs/Team 1 Design/design_data/xschem/CP_LF/images/CP_LF.sym.png
