SkillSurf/cmos-pll-ihp-sg13g2/Team Designs/Team 1 Design/design_data/xschem/DFlop/images/DFlop.sch.png

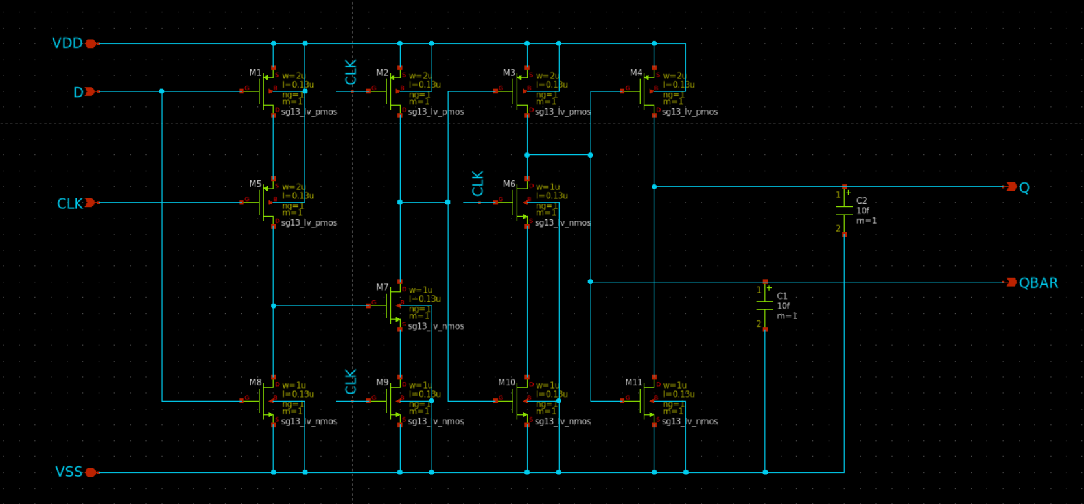
Team Designs/Team 1 Design/design_data/xschem/DFlop/images/DFlop.sch.png
