SkillSurf/cmos-pll-ihp-sg13g2/Team Designs/Team 1 Design/design_data/xschem/DFlop/images/DFlop_tb.png

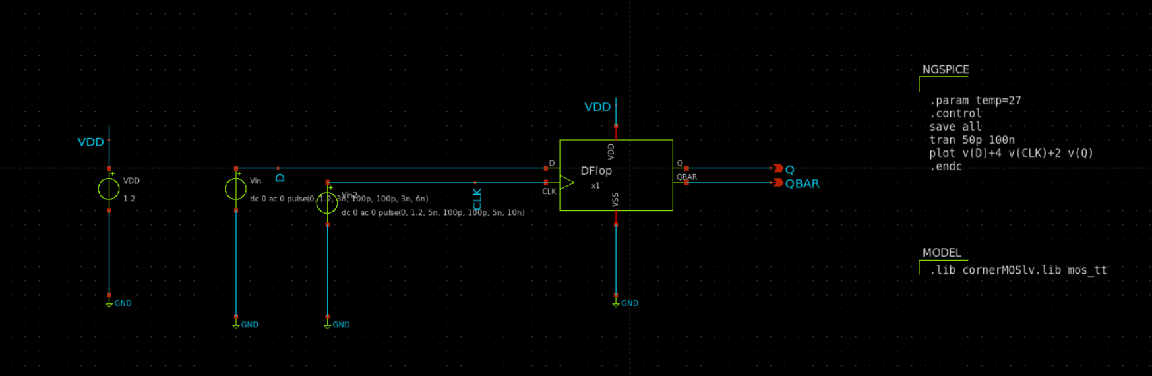
Team Designs/Team 1 Design/design_data/xschem/DFlop/images/DFlop_tb.png
