SkillSurf/cmos-pll-ihp-sg13g2/Team Designs/Team 1 Design/design_data/xschem/FD(Frequency_Dividers)/Div2F/images/Div2F_tb.png

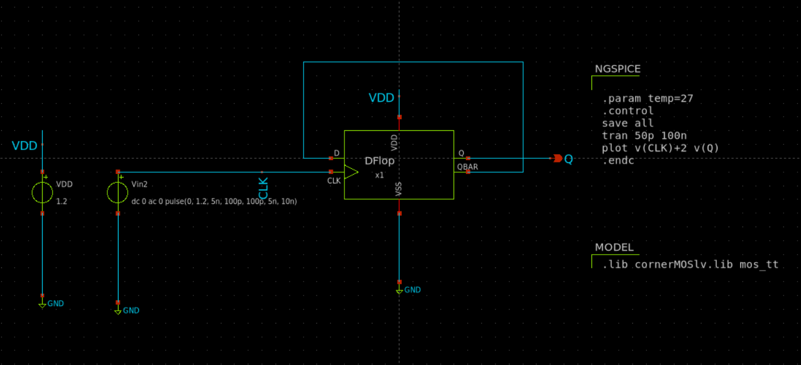
Team Designs/Team 1 Design/design_data/xschem/FD(Frequency_Dividers)/Div2F/images/Div2F_tb.png
