SkillSurf/cmos-pll-ihp-sg13g2/Team Designs/Team 1 Design/design_data/xschem/FD(Frequency_Dividers)/Div8F/images/Div8F.sym.png

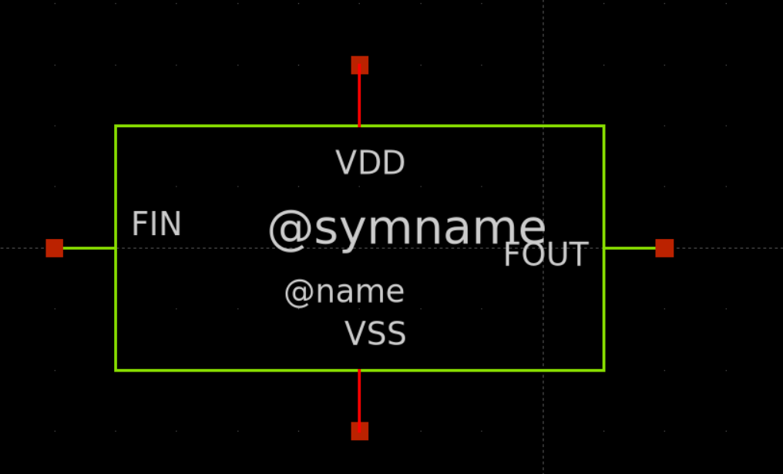
Team Designs/Team 1 Design/design_data/xschem/FD(Frequency_Dividers)/Div8F/images/Div8F.sym.png
