SkillSurf/cmos-pll-ihp-sg13g2/Team Designs/Team 1 Design/design_data/xschem/Inverter/images/inverter_symbol.png

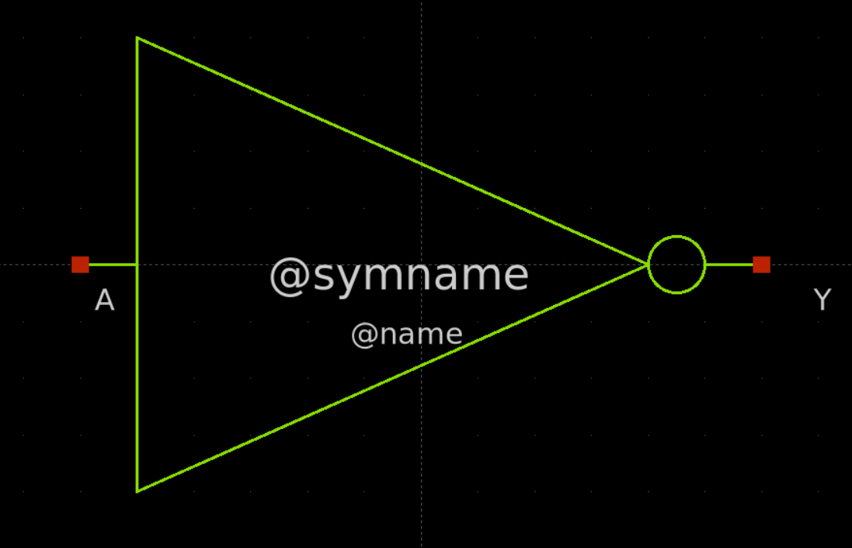
Team Designs/Team 1 Design/design_data/xschem/Inverter/images/inverter_symbol.png
