SkillSurf/cmos-pll-ihp-sg13g2/Team Designs/Team 1 Design/design_data/xschem/PLL_Completed/images/PLL_Completed.sch.png

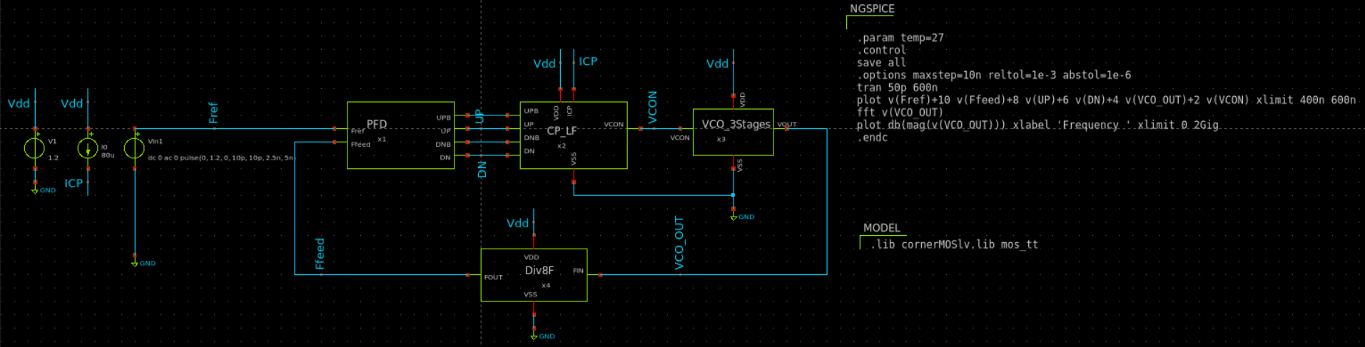
Team Designs/Team 1 Design/design_data/xschem/PLL_Completed/images/PLL_Completed.sch.png
