SkillSurf/cmos-pll-ihp-sg13g2/Team Designs/Team 1 Design/design_data/xschem/simulations/2_Input_NAND_New/2NAND_New_Simulation.png

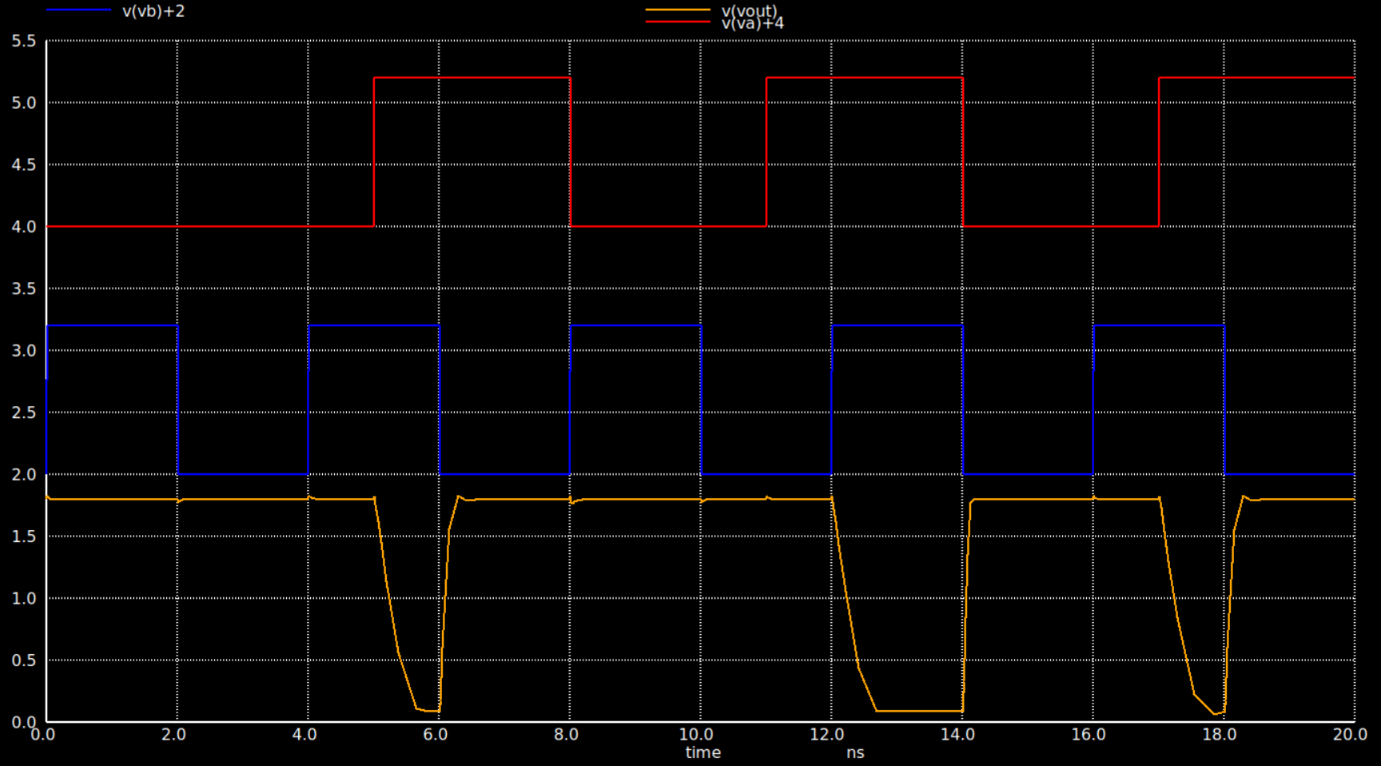
Team Designs/Team 1 Design/design_data/xschem/simulations/2_Input_NAND_New/2NAND_New_Simulation.png
