SkillSurf/cmos-pll-ihp-sg13g2/Team Designs/Team 1 Design/design_data/xschem/simulations/3_Input_NAND/3NAND_simulation.png

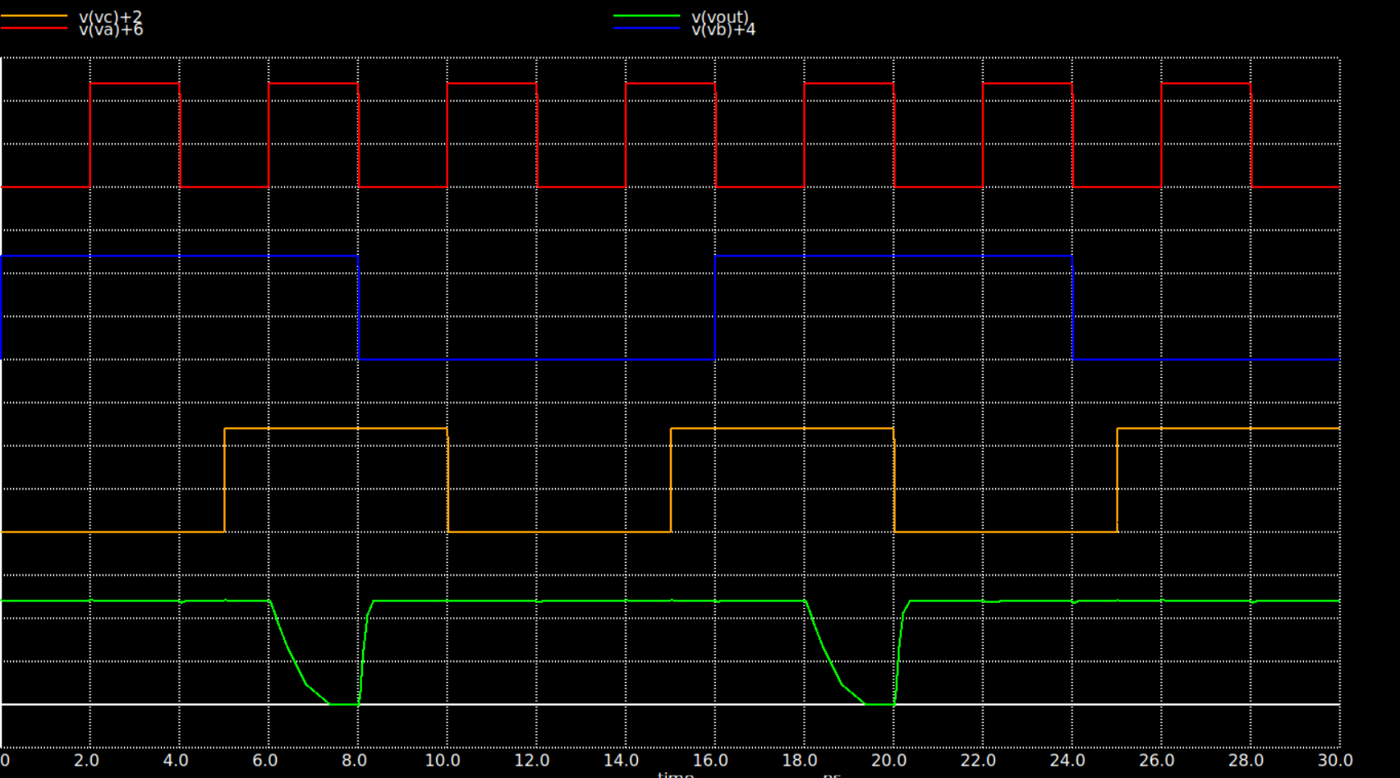
Team Designs/Team 1 Design/design_data/xschem/simulations/3_Input_NAND/3NAND_simulation.png
