SkillSurf/cmos-pll-ihp-sg13g2/Team Designs/Team 1 Design/design_data/xschem/simulations/CP_LF/CP_LF_simulation.sch.png

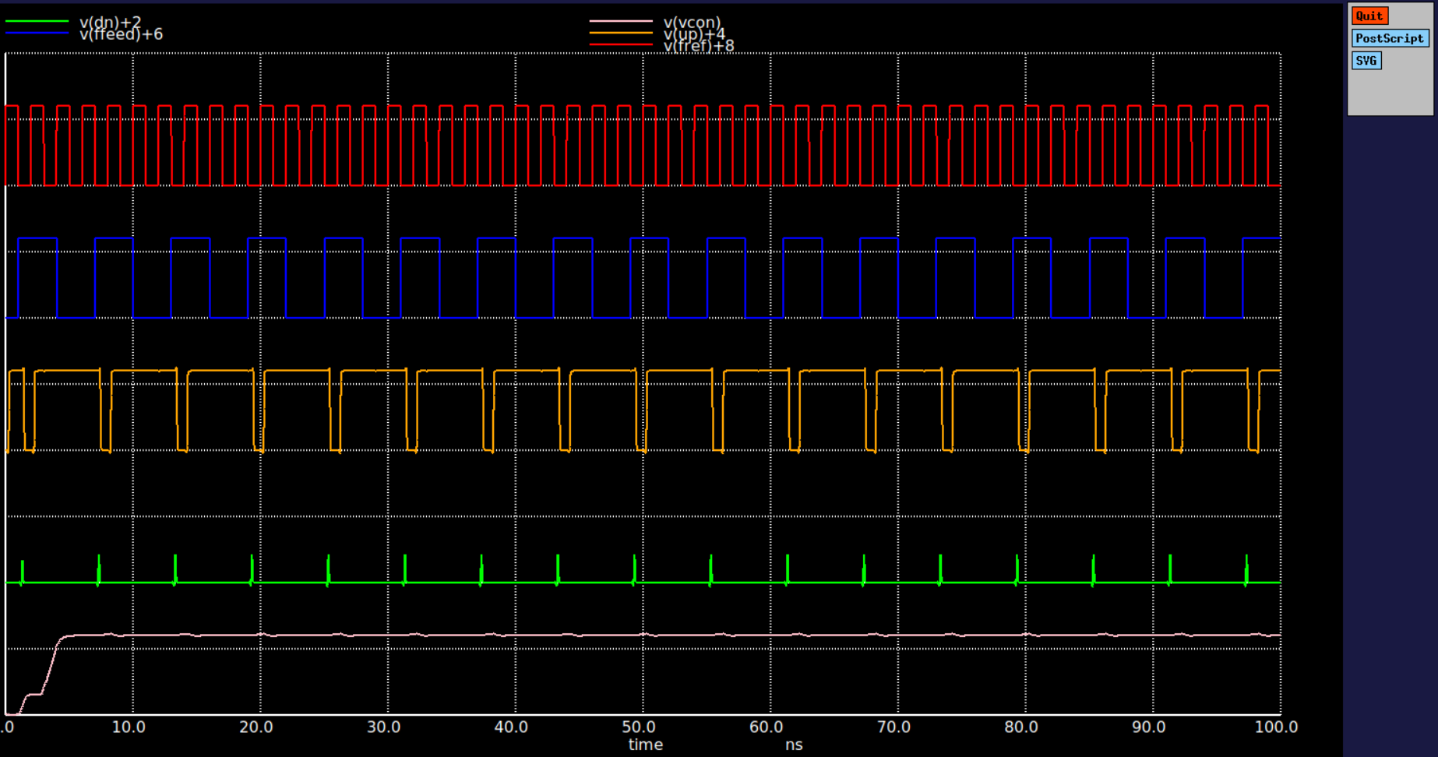
Team Designs/Team 1 Design/design_data/xschem/simulations/CP_LF/CP_LF_simulation.sch.png
