SkillSurf/cmos-pll-ihp-sg13g2/Team Designs/Team 1 Design/design_data/xschem/simulations/DFlop/DFlop_Simulation.png

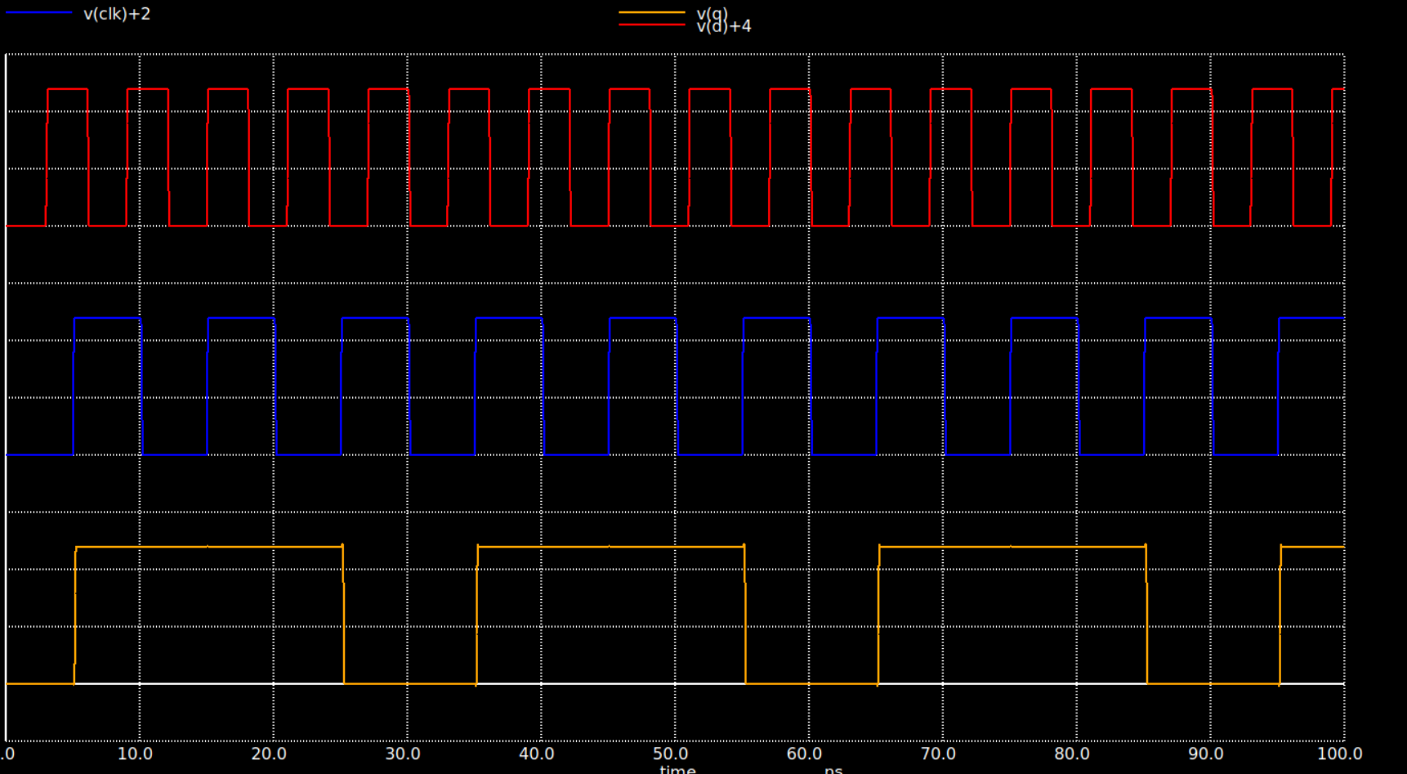
Team Designs/Team 1 Design/design_data/xschem/simulations/DFlop/DFlop_Simulation.png
