SkillSurf/cmos-pll-ihp-sg13g2/Team Designs/Team 1 Design/design_data/xschem/simulations/FD(Frequency_Dividers)/Div2F/Div2F_simulation.png

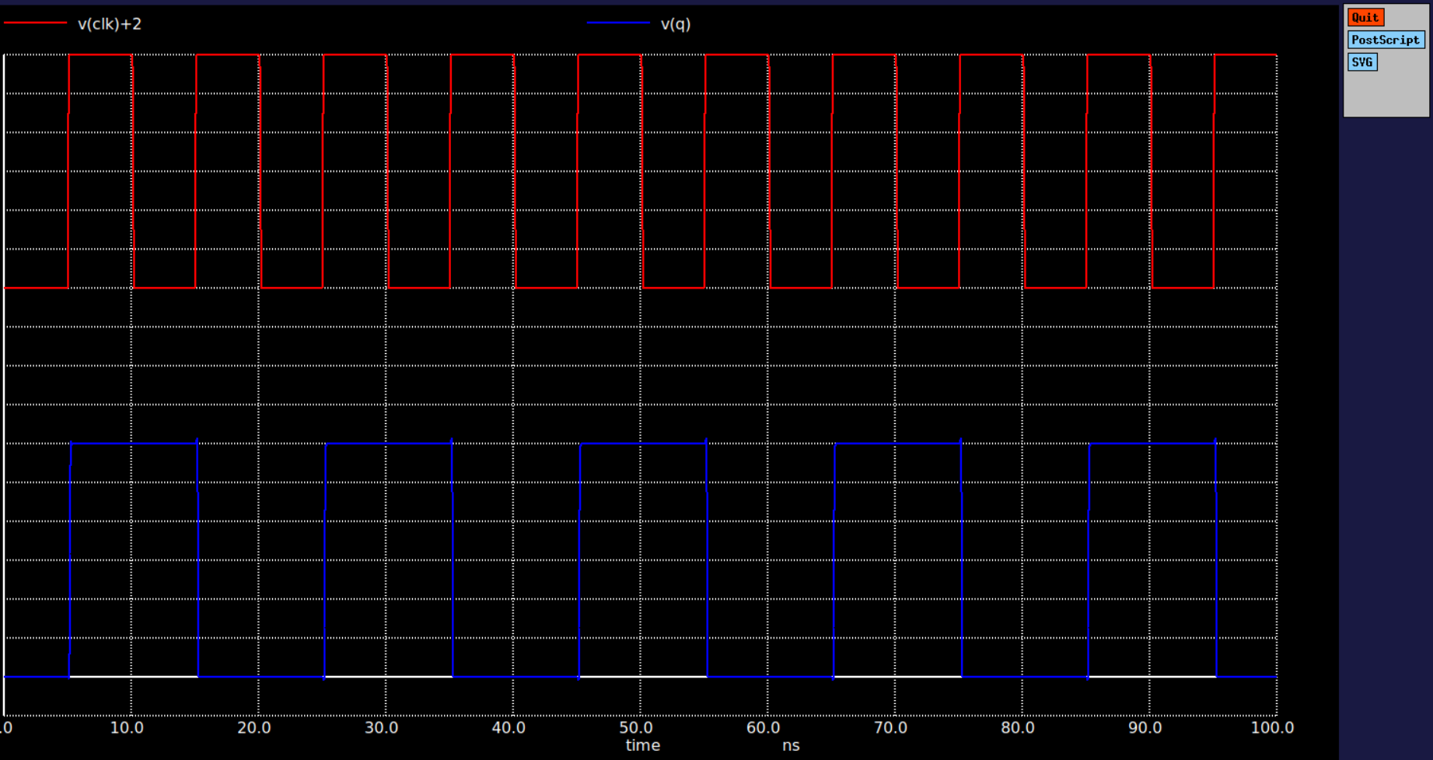
Team Designs/Team 1 Design/design_data/xschem/simulations/FD(Frequency_Dividers)/Div2F/Div2F_simulation.png
