SkillSurf/cmos-pll-ihp-sg13g2/Team Designs/Team 1 Design/design_data/xschem/simulations/FD(Frequency_Dividers)/Div8F/Div8F_Simulation.png

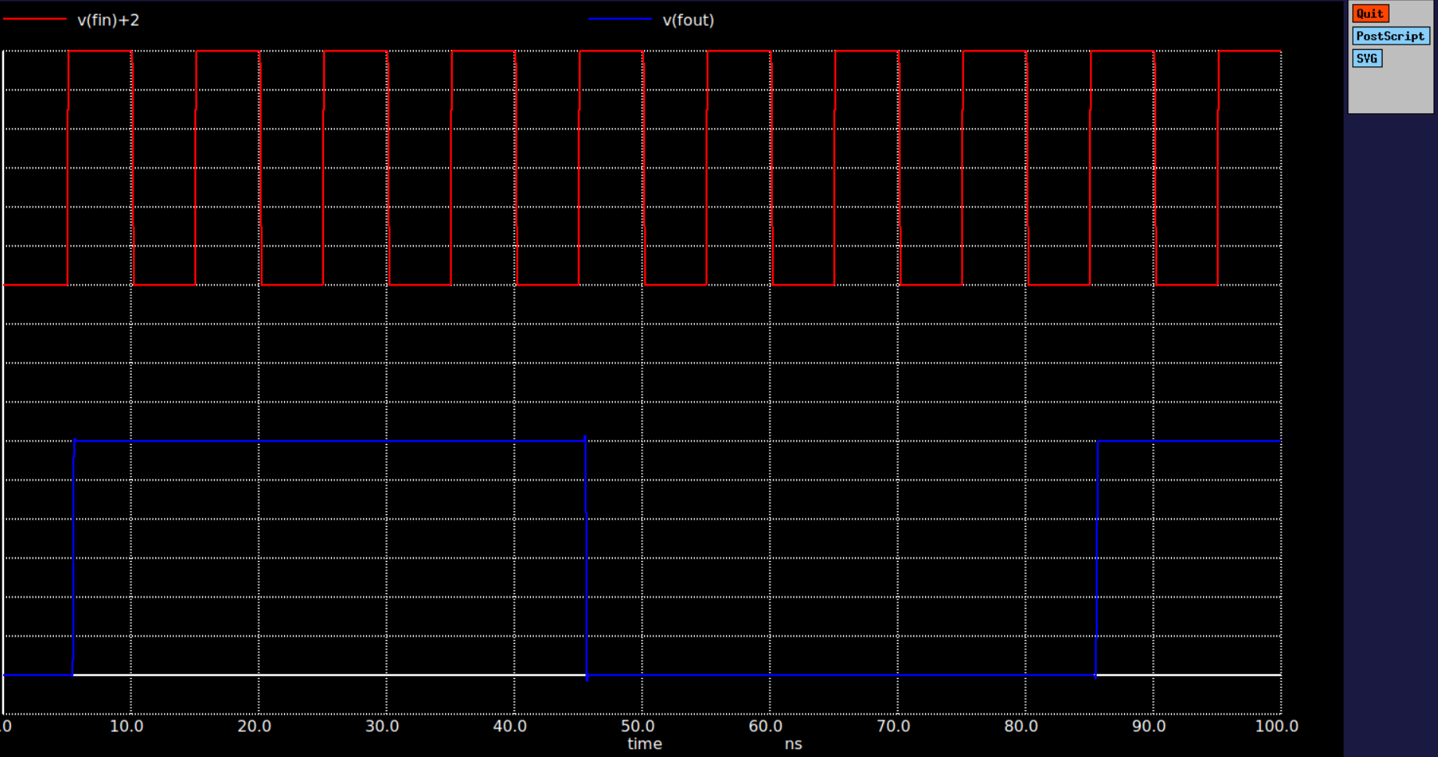
Team Designs/Team 1 Design/design_data/xschem/simulations/FD(Frequency_Dividers)/Div8F/Div8F_Simulation.png
