SkillSurf/cmos-pll-ihp-sg13g2/Team Designs/Team 1 Design/design_data/xschem/simulations/inverter/inverter_simulation.png

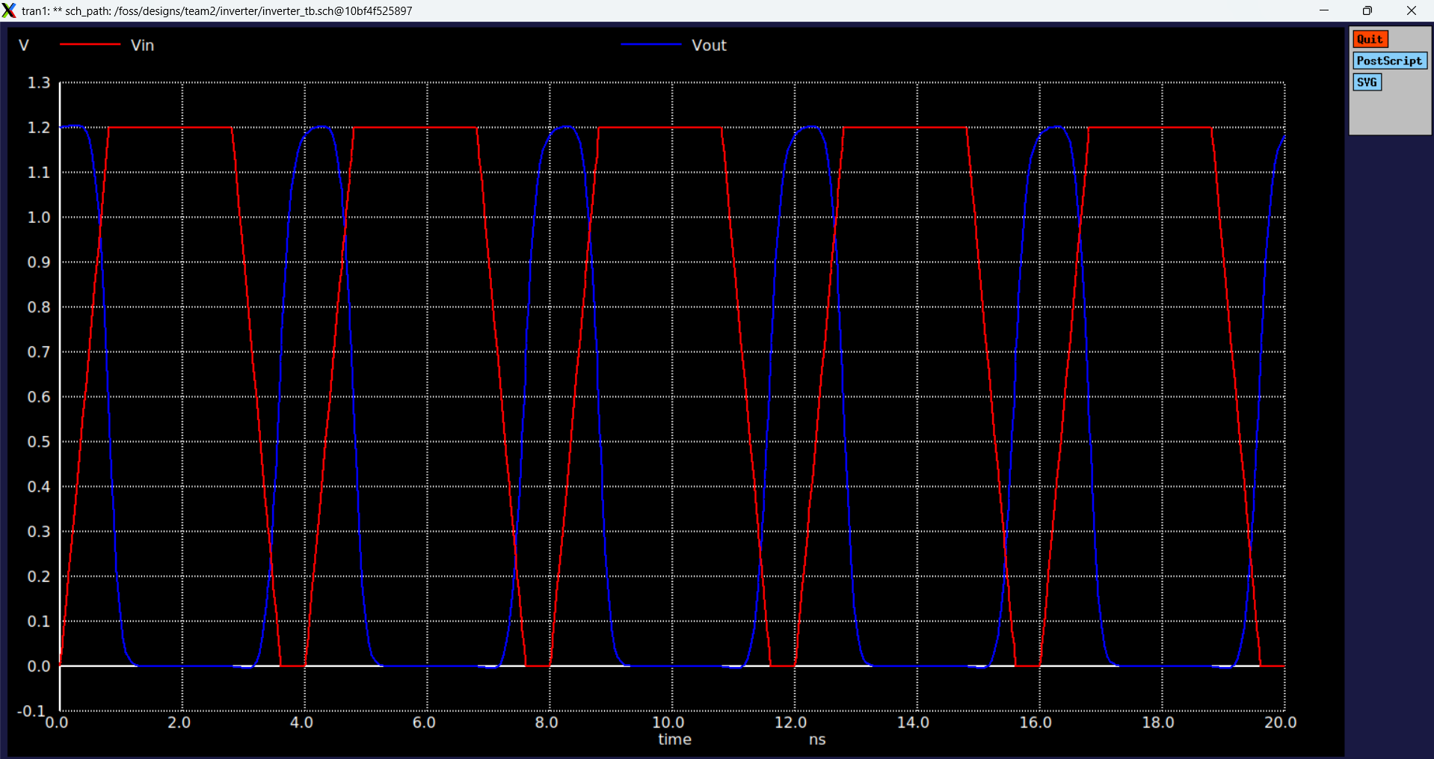
Team Designs/Team 1 Design/design_data/xschem/simulations/inverter/inverter_simulation.png
