SkillSurf/cmos-pll-ihp-sg13g2/Team Designs/Team 1 Design/design_data/xschem/simulations/PLL_Completed/FFT_Response(DivBy8_200MHzReferenceFrequencySignal).png

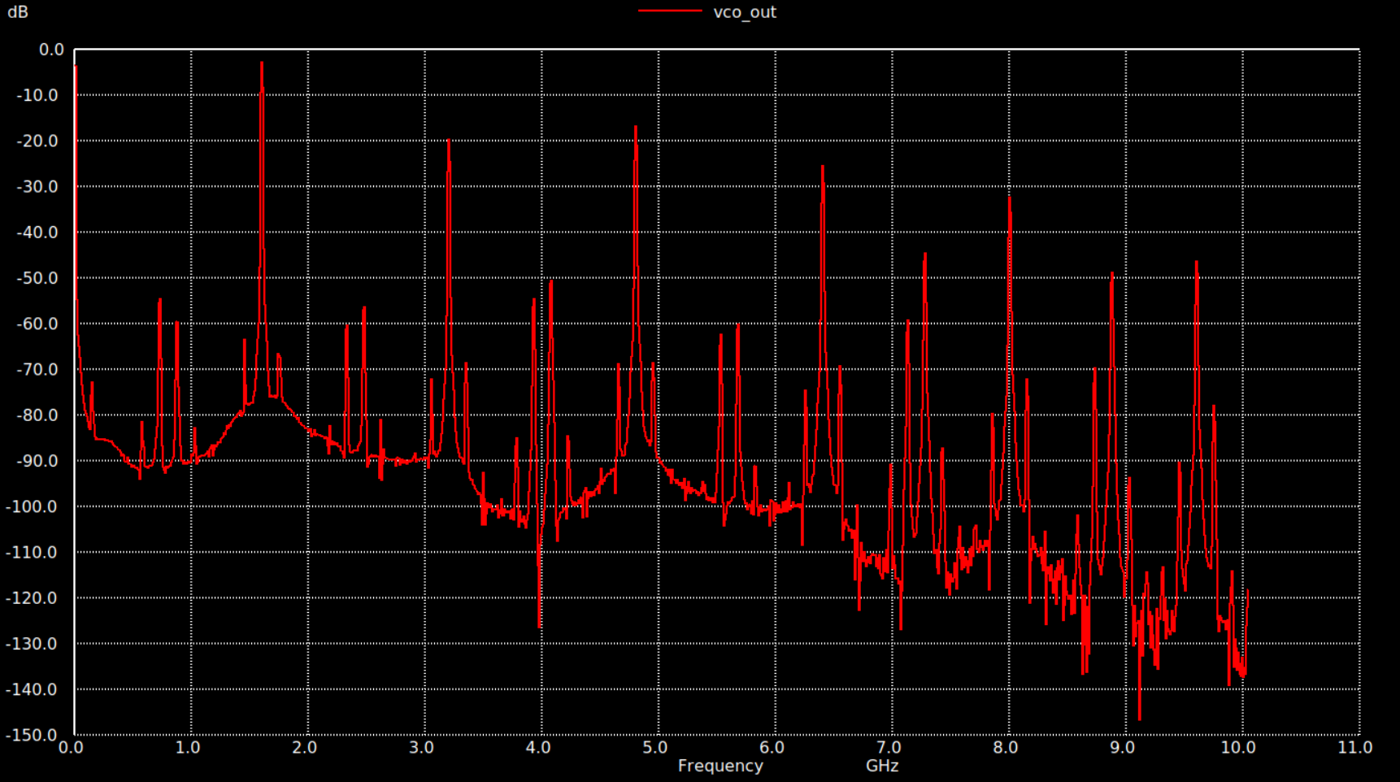
Team Designs/Team 1 Design/design_data/xschem/simulations/PLL_Completed/FFT_Response(DivBy8_200MHzReferenceFrequencySignal).png
