SkillSurf/cmos-pll-ihp-sg13g2/Team Designs/Team 1 Design/design_data/xschem/simulations/PLL_Completed/PLL_Completed_Simulation_200MHzReferenceClock.png

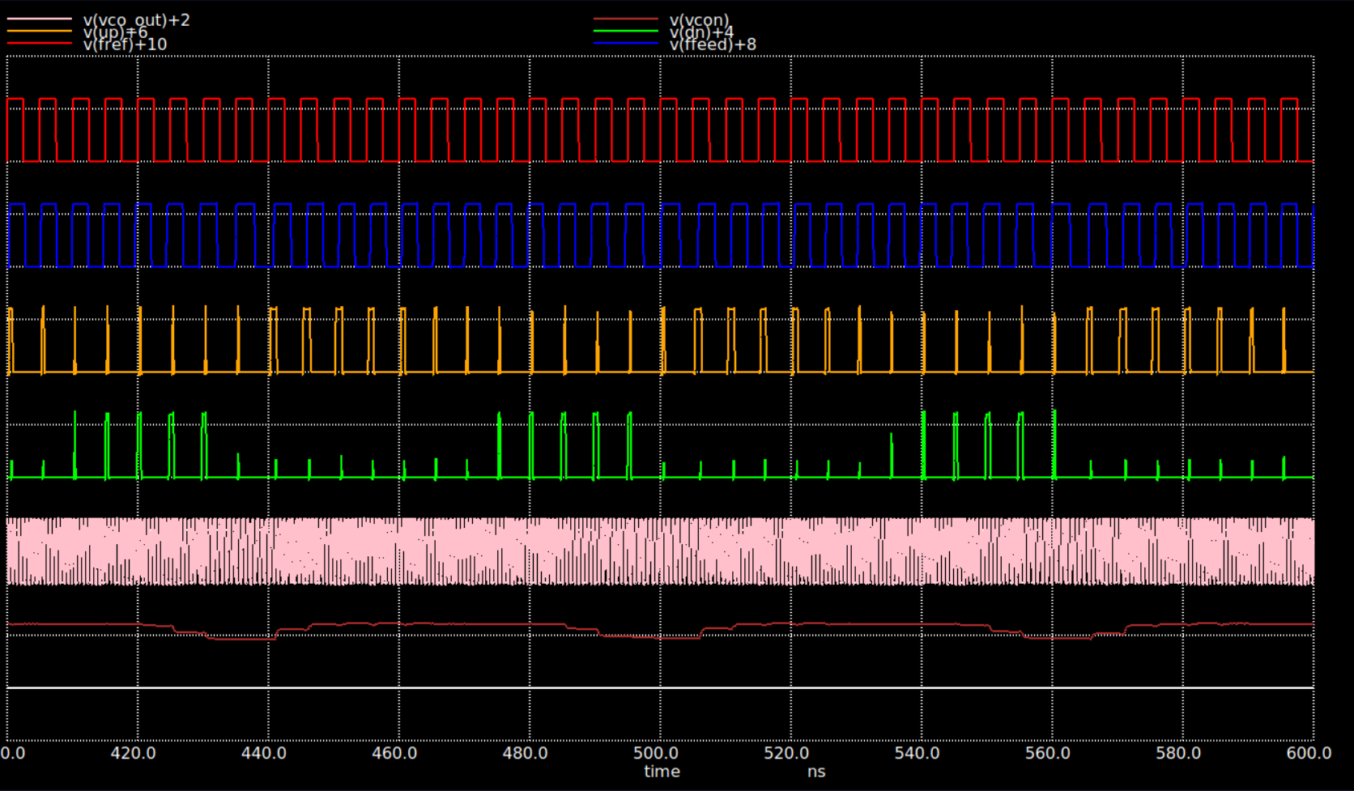
Team Designs/Team 1 Design/design_data/xschem/simulations/PLL_Completed/PLL_Completed_Simulation_200MHzReferenceClock.png
