SkillSurf/cmos-pll-ihp-sg13g2/Team Designs/Team 1 Design/design_data/xschem/simulations/VCO/FFT_Analysis/Vcontrol=0.8V/FFT_VCON=0.8V.png

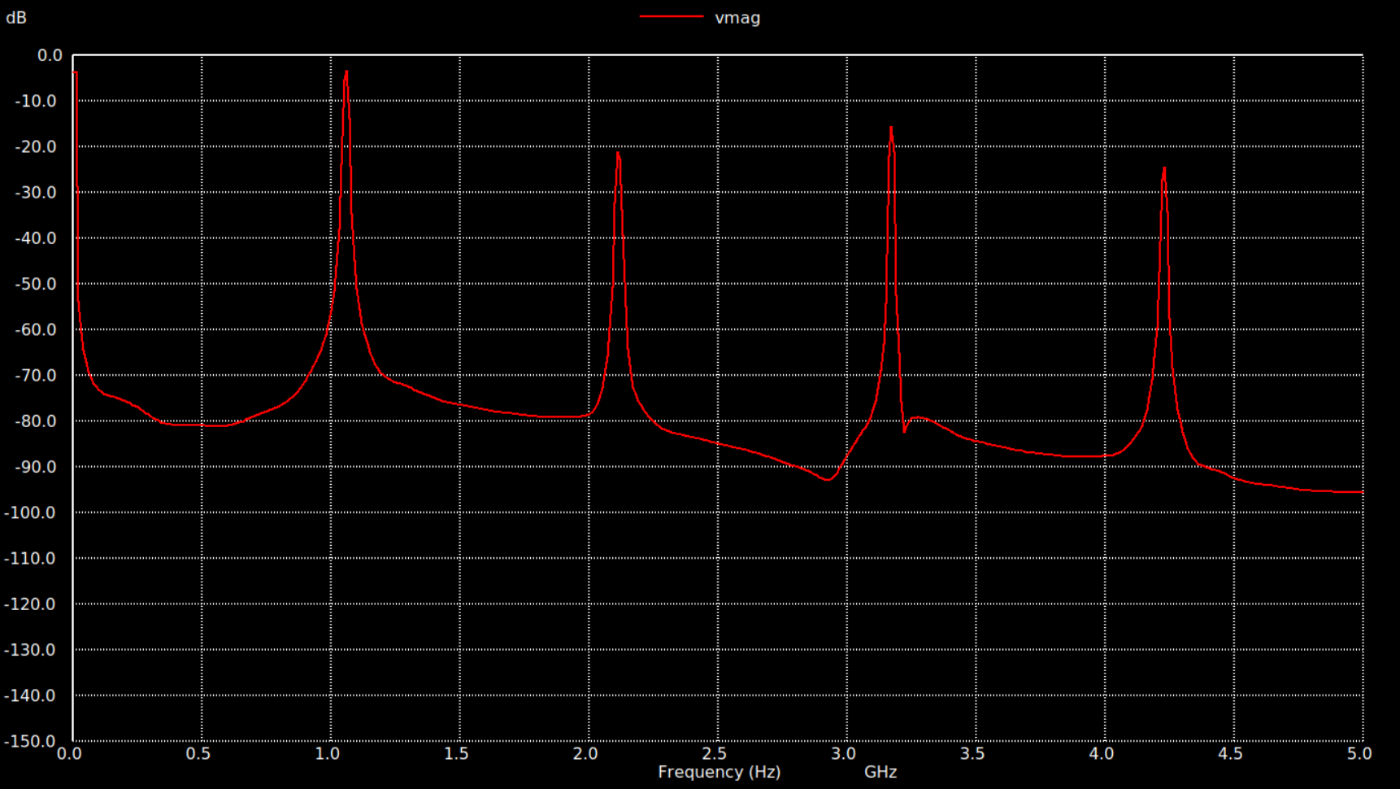
Team Designs/Team 1 Design/design_data/xschem/simulations/VCO/FFT_Analysis/Vcontrol=0.8V/FFT_VCON=0.8V.png
