SkillSurf/cmos-pll-ihp-sg13g2/Team Designs/Team 1 Design/design_data/xschem/simulations/VCO/FFT_Analysis/VcontrolVsFrequency/VCON_vs_Frequency.png

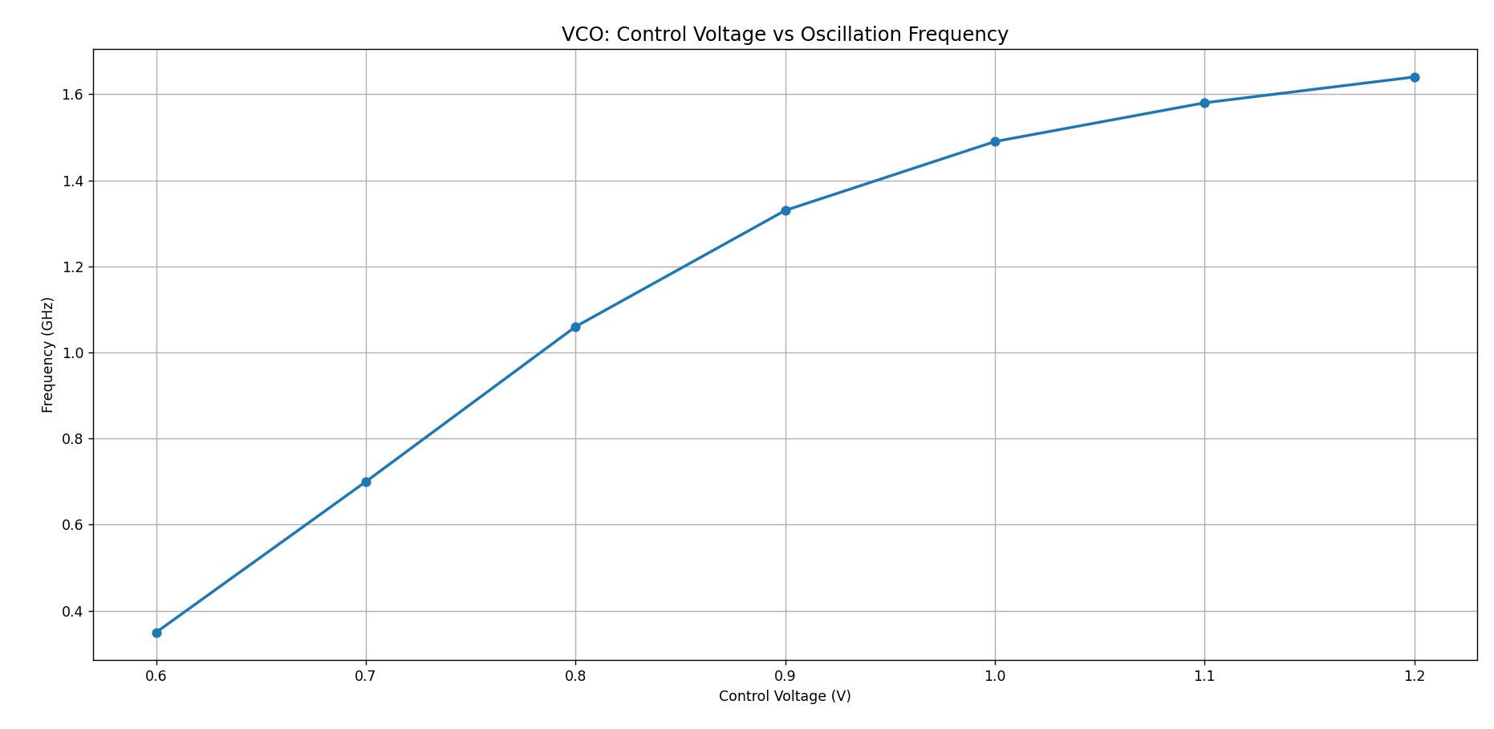
Team Designs/Team 1 Design/design_data/xschem/simulations/VCO/FFT_Analysis/VcontrolVsFrequency/VCON_vs_Frequency.png
