SkillSurf/cmos-pll-ihp-sg13g2/Team Designs/Team 2 Design/design_data/gds/images/t2_xor2_layout.png

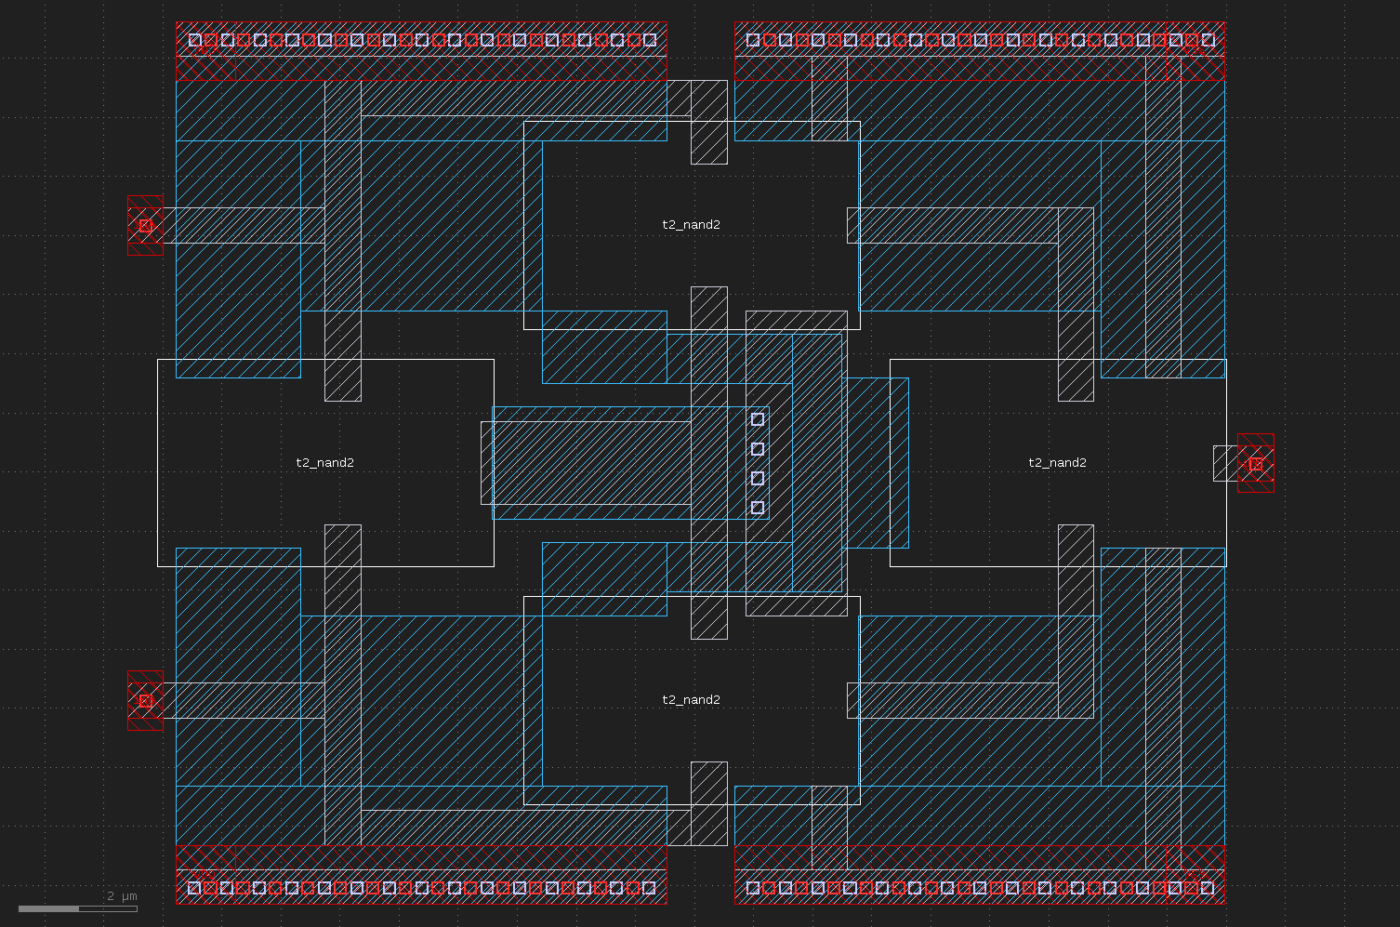
Team Designs/Team 2 Design/design_data/gds/images/t2_xor2_layout.png
