SkillSurf/cmos-pll-ihp-sg13g2/Team Designs/Team 2 Design/design_data/xschem/images/t2_vco_inverter_tb.png

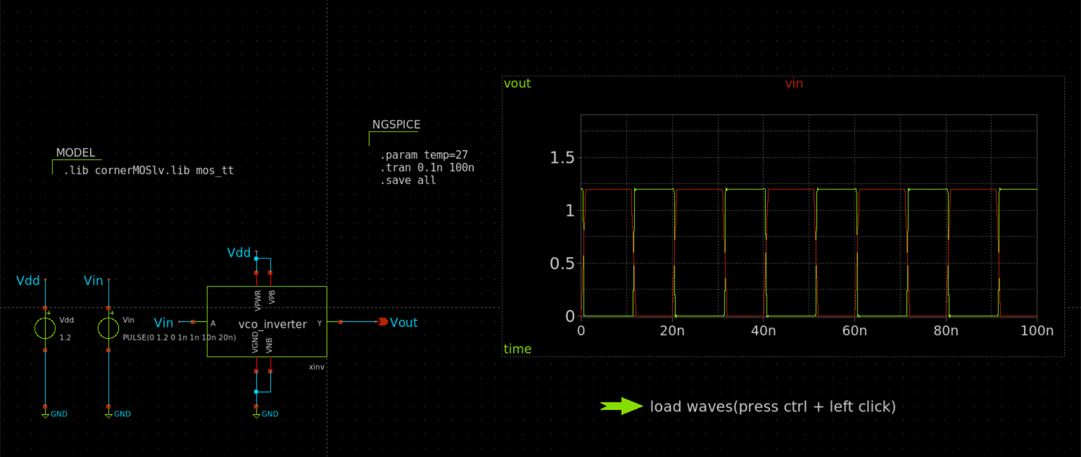
Team Designs/Team 2 Design/design_data/xschem/images/t2_vco_inverter_tb.png
