SkillSurf/cmos-pll-ihp-sg13g2/Team Designs/Team 2 Design/design_data/xschem/plots/t2_PFD_tb_plot.png

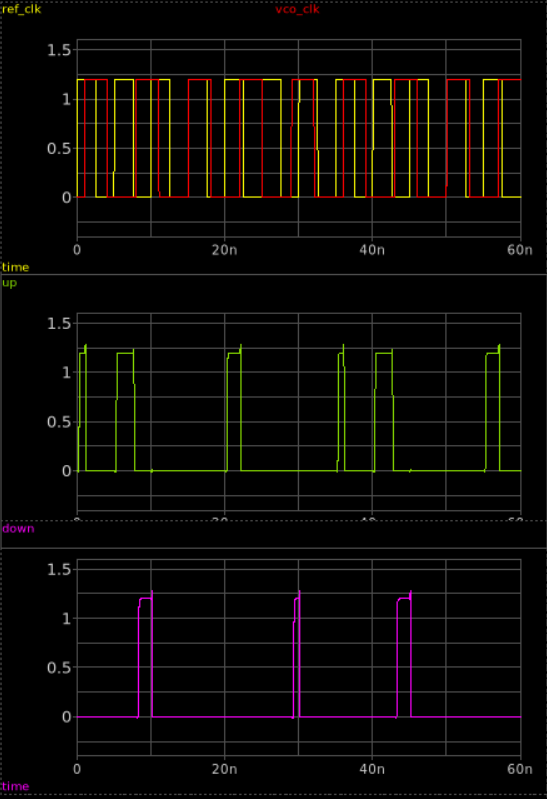
Team Designs/Team 2 Design/design_data/xschem/plots/t2_PFD_tb_plot.png
