SkillSurf/cmos-pll-ihp-sg13g2/Team Designs/Team 2 Design/design_data/xschem/plots/t2_vco_out_vcon=1.2.png

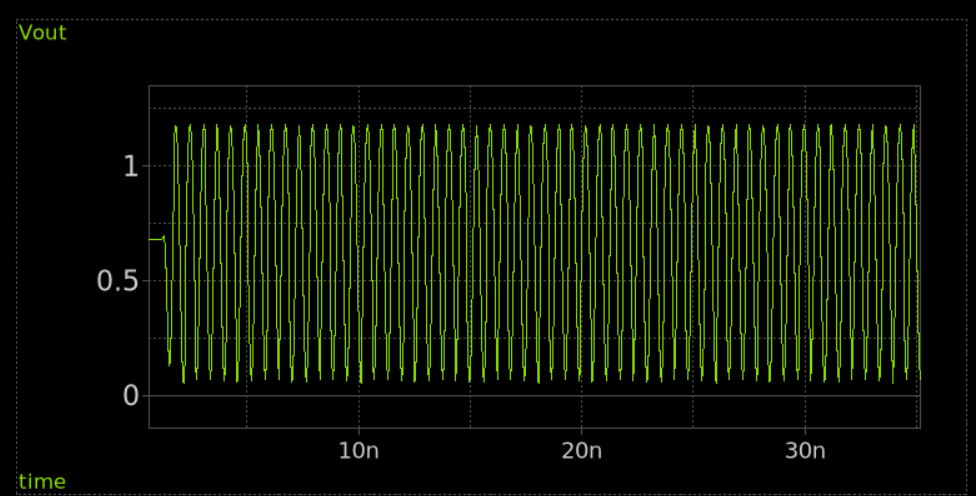
Team Designs/Team 2 Design/design_data/xschem/plots/t2_vco_out_vcon=1.2.png
