SkillSurf/cmos-pll-ihp-sg13g2/Combined_Design/design_data/gds/11Stage_vco_new_extracted.cir

* Extracted by KLayout with SG13G2 LVS runset on : 20/07/2025 14:12

.SUBCKT 11Stage_vco_new VGND VPWR vctl Vout
M$1 VGND vctl \$142 VGND sg13_lv_nmos L=0.13u W=0.6u AS=0.168p AD=0.168p
+ PS=2.02u PD=2.02u
M$3 VGND vctl \$137 VGND sg13_lv_nmos L=0.13u W=0.6u AS=0.168p AD=0.168p
+ PS=2.02u PD=2.02u
M$5 VGND vctl \$125 VGND sg13_lv_nmos L=0.13u W=0.6u AS=0.168p AD=0.168p
+ PS=2.02u PD=2.02u
M$7 VGND vctl \$134 VGND sg13_lv_nmos L=0.13u W=0.6u AS=0.168p AD=0.168p
+ PS=2.02u PD=2.02u
M$9 VGND vctl \$87 VGND sg13_lv_nmos L=0.13u W=0.6u AS=0.168p AD=0.168p
+ PS=2.02u PD=2.02u
M$11 VGND vctl \$85 VGND sg13_lv_nmos L=0.13u W=0.6u AS=0.168p AD=0.168p
+ PS=2.02u PD=2.02u
M$13 VGND vctl \$84 VGND sg13_lv_nmos L=0.13u W=0.6u AS=0.168p AD=0.168p
+ PS=2.02u PD=2.02u
M$15 \$85 \$55 \$54 VGND sg13_lv_nmos L=0.13u W=1u AS=0.28p AD=0.28p PS=2.62u
+ PD=2.62u
M$17 \$82 \$52 \$57 VGND sg13_lv_nmos L=0.13u W=1u AS=0.28p AD=0.28p PS=2.62u
+ PD=2.62u
M$19 VGND vctl \$86 VGND sg13_lv_nmos L=0.13u W=0.6u AS=0.168p AD=0.168p
+ PS=2.02u PD=2.02u
M$21 \$87 \$44 \$38 VGND sg13_lv_nmos L=0.13u W=1u AS=0.28p AD=0.28p PS=2.62u
+ PD=2.62u
M$23 \$84 \$54 \$53 VGND sg13_lv_nmos L=0.13u W=1u AS=0.28p AD=0.28p PS=2.62u
+ PD=2.62u
M$25 \$86 \$38 \$55 VGND sg13_lv_nmos L=0.13u W=1u AS=0.28p AD=0.28p PS=2.62u
+ PD=2.62u
M$27 VGND vctl \$126 VGND sg13_lv_nmos L=0.13u W=0.6u AS=0.168p AD=0.168p
+ PS=2.02u PD=2.02u
M$29 \$83 \$53 \$52 VGND sg13_lv_nmos L=0.13u W=1u AS=0.28p AD=0.28p PS=2.62u
+ PD=2.62u
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
+ PS=3.77u PD=5.24u
M$152 \$126 \$130 \$44 VGND sg13_lv_nmos L=0.13u W=1u AS=0.28p AD=0.28p
+ PS=2.62u PD=2.62u
M$154 \$44 \$130 \$156 VPWR sg13_lv_pmos L=0.13u W=2u AS=0.4412p AD=0.56p
+ PS=3.77u PD=5.24u
.ENDS 11Stage_vco_new
