SkillSurf/cmos-pll-ihp-sg13g2/Combined_Design/design_data/gds/Bias_gen_extracted.cir

* Extracted by KLayout with SG13G2 LVS runset on : 20/07/2025 08:34

.SUBCKT Bias_gen
R$1 11 13 rhigh w=1u l=12u ps=0 b=0 m=1
R$2 3 2 rhigh w=1u l=12u ps=0 b=0 m=1
M$3 10 6 2 1 sg13_lv_nmos L=1u W=1u AS=0.34p AD=0.34p PS=2.68u PD=2.68u
M$4 8 6 3 1 sg13_lv_nmos L=1u W=1u AS=0.34p AD=0.34p PS=2.68u PD=2.68u
M$5 6 6 2 1 sg13_lv_nmos L=1u W=1u AS=0.34p AD=0.34p PS=2.68u PD=2.68u
M$6 8 10 7 1 sg13_lv_nmos L=0.15u W=0.5u AS=0.17p AD=0.17p PS=1.68u PD=1.68u
M$7 6 4 2 1 sg13_lv_nmos L=0.15u W=0.5u AS=0.17p AD=0.17p PS=1.68u PD=1.68u
M$8 7 5 2 1 sg13_lv_nmos L=0.15u W=0.5u AS=0.17p AD=0.17p PS=1.68u PD=1.68u
M$9 6 8 11 9 sg13_lv_pmos L=1u W=4u AS=1.06p AD=1.06p PS=7.06u PD=7.06u
M$11 13 8 8 9 sg13_lv_pmos L=1u W=2u AS=0.68p AD=0.68p PS=4.68u PD=4.68u
M$12 13 12 12 9 sg13_lv_pmos L=0.15u W=0.5u AS=0.17p AD=0.17p PS=1.68u PD=1.68u
M$13 13 5 8 9 sg13_lv_pmos L=0.15u W=0.5u AS=0.17p AD=0.17p PS=1.68u PD=1.68u
M$14 12 10 10 9 sg13_lv_pmos L=0.15u W=0.5u AS=0.17p AD=0.17p PS=1.68u PD=1.68u
M$15 13 14 10 9 sg13_lv_pmos L=0.15u W=0.5u AS=0.17p AD=0.17p PS=1.68u PD=1.68u
.ENDS Bias_gen
