SkillSurf/cmos-pll-ihp-sg13g2/Combined_Design/design_data/xschem/11Stage_vco_new_extracted.cir

* Extracted by KLayout with SG13G2 LVS runset on : 10/07/2025 15:19

.SUBCKT 11Stage_vco_new
M$1 \$85 \$47 \$54 \$1 sg13_lv_nmos L=0.13u W=0.25u AS=0.1075p AD=0.0625p
+ PS=1.34u PD=0.74u
M$2 \$54 \$47 \$85 \$1 sg13_lv_nmos L=0.13u W=0.25u AS=0.0625p AD=0.1075p
+ PS=0.74u PD=1.34u
M$3 \$86 \$48 \$47 \$1 sg13_lv_nmos L=0.13u W=0.25u AS=0.1075p AD=0.0625p
+ PS=1.34u PD=0.74u
M$4 \$47 \$48 \$86 \$1 sg13_lv_nmos L=0.13u W=0.25u AS=0.0625p AD=0.1075p
+ PS=0.74u PD=1.34u
M$5 \$87 \$49 \$48 \$1 sg13_lv_nmos L=0.13u W=0.25u AS=0.1075p AD=0.0625p
+ PS=1.34u PD=0.74u
M$6 \$48 \$49 \$87 \$1 sg13_lv_nmos L=0.13u W=0.25u AS=0.0625p AD=0.1075p
+ PS=0.74u PD=1.34u
M$7 \$88 \$50 \$49 \$1 sg13_lv_nmos L=0.13u W=0.25u AS=0.1075p AD=0.0625p
+ PS=1.34u PD=0.74u
M$8 \$49 \$50 \$88 \$1 sg13_lv_nmos L=0.13u W=0.25u AS=0.0625p AD=0.1075p
+ PS=0.74u PD=1.34u
M$9 \$89 \$51 \$50 \$1 sg13_lv_nmos L=0.13u W=0.25u AS=0.1075p AD=0.0625p
+ PS=1.34u PD=0.74u
M$10 \$50 \$51 \$89 \$1 sg13_lv_nmos L=0.13u W=0.25u AS=0.0625p AD=0.1075p
+ PS=0.74u PD=1.34u
M$11 \$90 \$52 \$51 \$1 sg13_lv_nmos L=0.13u W=0.25u AS=0.1075p AD=0.0625p
+ PS=1.34u PD=0.74u
M$12 \$51 \$52 \$90 \$1 sg13_lv_nmos L=0.13u W=0.25u AS=0.0625p AD=0.1075p
+ PS=0.74u PD=1.34u
M$13 \$106 \$104 \$85 \$1 sg13_lv_nmos L=0.13u W=0.3u AS=0.102p AD=0.066p
+ PS=1.28u PD=0.74u
M$14 \$85 \$104 \$106 \$1 sg13_lv_nmos L=0.13u W=0.3u AS=0.066p AD=0.102p
+ PS=0.74u PD=1.28u
M$15 \$107 \$104 \$86 \$1 sg13_lv_nmos L=0.13u W=0.3u AS=0.102p AD=0.066p
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
C$154 \$3 \$148 cap_cmim w=6.99u l=6.99u A=48.8601p P=27.96u m=1
C$155 \$3 \$37 cap_cmim w=6.99u l=6.99u A=48.8601p P=27.96u m=1
C$156 \$3 \$146 cap_cmim w=6.99u l=6.99u A=48.8601p P=27.96u m=1
C$157 \$3 \$149 cap_cmim w=6.99u l=6.99u A=48.8601p P=27.96u m=1
.ENDS 11Stage_vco_new
