SkillSurf/cmos-pll-ihp-sg13g2/(commit log)

2025-06-01 Created t2_inverter.sch, t2_inverter.sym
    Further tested the functionality with t2_inverter_tb_dc.sch
    [t2_inverter.sch, t2_inverter_tb_dc.sch]
2025-06-01 inverter updated
    [t2_inverter.sch, t2_inverter_tb_dc.sch]
2025-06-01 -test design of t2_charge_pump added.
    [t2_charge_pump.sch]
2025-06-01 created vco(t2_vco.sch)
    [t2_vco.sch]
2025-06-01 NAND gate files updated
    [t2_nand2.sch, t2_nand2_tb.sch]
2025-06-02 Created Tie cell
    To connect pull-ups (Tie HIGH) and pull-downs (Tie-LOW) for floating Gate pins.
    [t2_nand2.sch, t2_nand2_tb.sch, t2_tie.sch, t2_tie_tb.sch]
2025-06-02 Created AND_2, XOR_2 and HA logic blocks
    [t2_and2.sch, t2_ha.sch, t2_ha_tb.sch, t2_nand2_tb.sch, t2_tie_tb.sch, t2_xor2.sch]
2025-06-02 added test schematic for loop filter.
    [t2_charge_pump.sch, t2_loop_filter.sch]
2025-06-02 Inverter symbol/parameters updated
    Changed L (0.45u --> 0.13u), W_PMOS (1.0u --> 0.3u) and W_NMOS (1.0u --> 0.15u).
    [t2_dff.sch, t2_inverter.sch]
2025-06-02 Created NAND_3
    [t2_dff.sch, t2_nand3.sch]
2025-06-02 vco updated
    [t2_vco.sch]
2025-06-02 vco vnb,vpb updated
    [t2_vco.sch]
2025-06-02 Created DFF block w/ tb
    [t2_dff.sch, t2_dff_tb.sch]
2025-06-02 vco modified, bias gen created
    [t2_bias.sch, t2_inverter_tb_pulse.sch, t2_vco.sch, t2_vco_tb.sch]
2025-06-03 charge pump tb added
    [t2_charge_pump.sch, t2_charge_pump_tb.sch]
2025-06-03 bias gen tb created
    [t2_bias_tb.sch, t2_vco.sch]
2025-06-03 inverter tb updated
    [t2_inverter_tb_pulse.sch]
2025-06-03 inverter added to charge pump
2025-06-03 t2_dff file name updated
    [t2_dff_1.sch, t2_dff_1_tb.sch]
2025-06-03 VCO_tb simulated
    [t2_vco.sch, t2_vco_tb.sch]
2025-06-03 VCO simulated
    [t2_vco.sch, t2_vco_tb.sch]
2025-06-03 Created 1-bit divider_cell w/ tb
    [t2_divider_cell_tb.sch, t2_or2.sch, t2_or4.sch]
2025-06-03 VCO modified, vco_inverter created, tb updated
    [t2_bias.sch, t2_bias_tb.sch, t2_inverter_tb_pulse.sch, t2_vco.sch, t2_vco_inverter.sch, t2_vco_inverter_tb_pulse.sch, t2_vco_tb.sch]
2025-06-04 Created Freq_Divider block
    [t2_freq_divider.sch, t2_freq_divider_tb.sch]
2025-06-04 vco latest
    [t2_vco.sch, t2_vco_inverter_tb_pulse.sch, t2_vco_tb.sch]
2025-06-04 Added design files to Team 2 Design folder
    [t2_PFD.sch, t2_PFD_tb.sch]
2025-06-04 new vco design
    [t2_vco.sch, t2_vco_new_tb_.sch, t2_vco_tb_test.sch]
2025-06-04 Added new DFF and parametric simulation of Freq_Divider
    New DFF (t2_dff_2) - Less transistors, less performance
    Parametric simulation - N vs Frequency (MHz)
    [t2_dff_2.sch, t2_dff_2_tb.sch, t2_freq_divider_sweep.sch, t2_freq_divider_tb.sch]
2025-06-04 VCO sweep tried
    [t2_vco_new_sweep_.sch, t2_vco_sweep_.sch]
2025-06-05 changed caps in loop filter
    [t2_loop_filter.sch]
2025-06-05 Set N=7 in Freq_Divider
    [t2_freq_divider_tb.sch]
2025-06-05 plots, spice files added
    [t2_vco_new_tb_.sch, vctl_vs_freq.xlsx]
2025-06-05 draft pll added
    [pll.sch, untitled.sch]
2025-06-05 renamed pll to t2_pll
    [t2_pll.sch, untitled.sch]
2025-06-05 bias generator simulated, images added
    [t2_bias_tb.sch, t2_vco_new_sweep.sch, t2_vco_new_tb.sch, t2_vco_new_tb_.sch, t2_vco_sweep.sch, t2_vco_sweep_.sch, t2_vco_tb.sch]
2025-06-05 Added t2_nand2 layout w\o LVS
    [t2_nand2.sch]
2025-06-07 updated t2_pll
    [t2_loop_filter.sch, t2_pll.sch]
2025-06-07 updated t2_pll to bypass freq_div
    [t2_PFD_tb.sch, t2_charge_pump.sch, t2_pll.sch, t2_vco_new.sch]
2025-06-10 LVS for NAND2
    Also modified the folder structure
    [vctl_vs_freq.xlsx]
2025-06-10 DRC checked for PMOS and VCO_inverter
    [t2_vco_new.sch, t2_vco_new_tb.sch]
2025-06-10 LVS for multiple sub-circuits
    LVS tested for t2_xor2, t2_and2, t2_ha, t2_inverter, t2_nand3, t2_or2, t2_or4
    [t2_nand3.sch]
2025-06-11 LVS for t2_dff
    CHnaged the pin assignments of t2_nand3 : inC <=> inA
    [t2_nand3.sch]
2025-06-11 VCO simulation images added
    [t2_vco_new_tb.sch]
2025-06-12 bias drive added to charge_pump_tb
    [t2_bias.sch, t2_charge_pump.sch, t2_charge_pump_tb.sch]
2025-06-13 t2_bias layout w/o lvs added
    [t2_bias.sch, t2_charge_pump_tb.sch, t2_loop_filter.sch]
2025-06-13 t2_loop_filter layout added w/o lvs
    [t2_loop_filter.sch]
2025-06-13 t2_charge_pump layout added w/o lvs
    [t2_charge_pump.sch]
2025-06-27 Created DFF_nCLK block
    [dff_nclk.sch, dff_nclk_tb.sch, dff_tb.sch]
2025-06-27 inverter schem and symb added
    [inverter.sch]
2025-06-27 inverter_tb added
    [charge_pump.sch, charge_pump_tb.sch, inverter_tb.sch, loop_filter.sch]
2025-06-28 DFF_nCLK /w LVS
    [dff_nclk.sch]
2025-06-28 Half_Adder simulation
    [dff_nclk_tb.sch, half_add.sch, half_add_tb.sch]
2025-06-28 charge_pump_tb added
    [charge_pump.sch, charge_pump_tb.sch]
2025-06-29 loop filter updated
    [charge_pump_tb.sch, loop_filter.sch]
2025-07-01 draft charge_pump.gds added
2025-07-01 draft loop_filter.gds added
    [loop_filter.sch]
2025-07-02 Freq_Divider_Cell simulation
    [freq_div_cell.sch, freq_div_cell_tb.sch]
2025-07-02 2-Bit_Freq_Divider simulation
    [2-bit_freq_divider.sch, 2-bit_freq_divider_tb.sch, freq_div_cell_tb.sch]
2025-07-02 3-Bit_Freq_Divider simulation
    [3-bit_freq_divider.sch, 3-bit_freq_divider_tb.sch]
2025-07-03 Freq_Divider_Cell /w DRC and LVS
    [freq_div_cell.sch]
2025-07-04 2Bit_Freq_Divider /w DRC and LVS
    [2bit_freq_divider.sch]
2025-07-04 2-bit Divider filename update
    [2bit_freq_divider_tb.sch]
2025-07-06 bias_gen_tb.sch added
    [Bias_gen_tb.sch]
2025-07-06 charge_pump_tb updated
    [charge_pump_tb.sch]
2025-07-06 charge_pump.gds updated
2025-07-06 draft pll_tb.sch added.
    [PFD.sch, pll_tb.sch]
2025-07-07 updated draft pll_noDiv_tb.sch
    [pll_noDiv_tb.sch, pll_tb.sch]
2025-07-07 3-bit Divider filename update
    [3bit_freq_divider.sch, 3bit_freq_divider_tb.sch]
2025-07-07 draft pll_2bitDiv.sch added
    [pll_2bitDiv.sch, pll_2bitDiv_tb.sch]
2025-07-08 Draft pll_3bitDiv.sch added
    [pll_2bitDiv_tb.sch, pll_3bitDiv.sch, pll_3bitDiv_tb.sch]
2025-07-08 updated charge pump and bias gen
    [Bias_gen.sch, charge_pump.sch, charge_pump_tb.sch, charge_pump_wo_lpf_tb.sch]
2025-07-08 updated bias_gen
    [Bias_gen.sch, pll_noDiv_tb.sch]
2025-07-08 Updated pll_noDiv simulation
    [pll_2bitDiv_tb.sch, pll_noDiv_tb.sch]
2025-07-09 Updated pll_2bitDiv, pll_3bitDiv simulation
    [pll_2bitDiv_tb.sch, pll_3bitDiv_tb.sch]
2025-07-11 3Bit_Freq_Divider /w DRC and LVS
    [3bit_freq_divider.sch]
2025-07-11 charge pump and loop filter gds updated after tunning
2025-07-12 PFD update
    [pll_3bitDiv_tb.sch]
2025-07-16 pll_3bitDiv simulation updated
    [pll_3bitDiv.sch, pll_3bitDiv_optran.sch]
2025-07-18 draft pll_3bitDiv.gds updated
    [11Stage_vco_new.sch]
2025-07-19 11Stage_vco_new.gds lvs passed
    [11Stage_vco_new.sch]
2025-07-19 Added LVS files for pll_3bitDiv
    [11Stage_vco_new.sch, pll_3bitDiv.sch]
2025-07-19 pll routed without vdd gnd EN nEN pins
2025-07-20 pll_3bitDiv routed except vdd gnd
2025-07-20 pll_3bitDiv gnd connections added
2025-07-22 pll_3bitDiv.pex.spice added
    [11Stage_vco_new.sch, pll_3bitDiv_tb.sch]
2025-07-22 Updated tb commands with PEX files
    [pll_3bitDiv_tb.sch]
2025-07-27 Update folder name to "Combined_Design"
    [11Stage_vco_new.sch, 11Stage_vco_new_tb.sch, 2bit_freq_divider.sch, 2bit_freq_divider_tb.sch, 3bit_freq_divider.sch, 3bit_freq_divider_tb.sch, Bias_gen.sch, Bias_gen_tb.sch]
2025-07-27 Post layout simulation for dff_nclk
    [dff_nclk_pex_tb.sch]
2025-07-28 vco without buffer stage - vvco_wob added.
    [vco_wob.sch]
2025-07-28 removed scattered vco files
    [11Stage_vco_new.sch, 11Stage_vco_new_tb.sch]
2025-08-04 3bit_freq_divider PEX - Not Working
    [3bit_freq_divider_pex_tb.sch]
2025-08-04 half_add PEX (Done), freq_div_cell PEX (NOT Done)
    [freq_div_cell_pex_tb.sch, half_add_pex_tb.sch]
2025-08-09 freq_div_cell PEX (Done), 2bit_freq_divider PEX (Done)
    [2bit_freq_divider_pex_tb.sch]
2025-08-09 3bit_freq_divider PEX (Done)
    [3bit_freq_divider_pex_tb.sch]
2025-08-09 pll updated. Added vco withothout buffer stage.
    [pll_3bitDiv.sch, pll_3bitDiv_tb.sch]
2025-08-09 pll_3bitDiv post layout simulation not fixed
    [pll_3bitDiv_pex_tb.sch]
2025-08-09 pll_3bitDiv post layout error /w node
    [pll_3bitDiv_pex_tb.sch]
2025-08-10 PLL folder restructure
    [2NAND.sch, 2NAND_tb.sch, 3NAND.sch, 3NAND_tb.sch, CP_LF.sch, CP_LF_tb.sch, DFlop.sch, DFlop_tb.sch]
2025-08-11 Integrated PLL .tran updated
    [pll_3bitDiv_pex_tb.sch]
2025-08-12 Integrated PLL .tran running
    [pll_3bitDiv_pex_tb.sch]
2025-08-12 pll_3bitDiv_filled.gds drc passed
    [PFD_tb.sch, vco_wob_tb.sch]
2025-08-15 updated_readme_hansa_part1
    added schematic, layout images of charge pump and loop filter.
2025-08-15 update_readme_hansa_part3
    charge_pump + loop filter + bias gen simulation results added.
2025-08-16 Simulation updated
    [pll_3bitDiv_pex_tb.sch]
2025-08-16 VCO readme
    [charge_pump_wo_lpf_tb.sch, vco_wob_tb.sch]
2025-08-18 Readme updated
    [PFD.sch]
2025-09-01 Added power calculation scripts
